BorisIvanovGIT/DiplomnaRabota/Layout Snips/3D_BOT_2.png

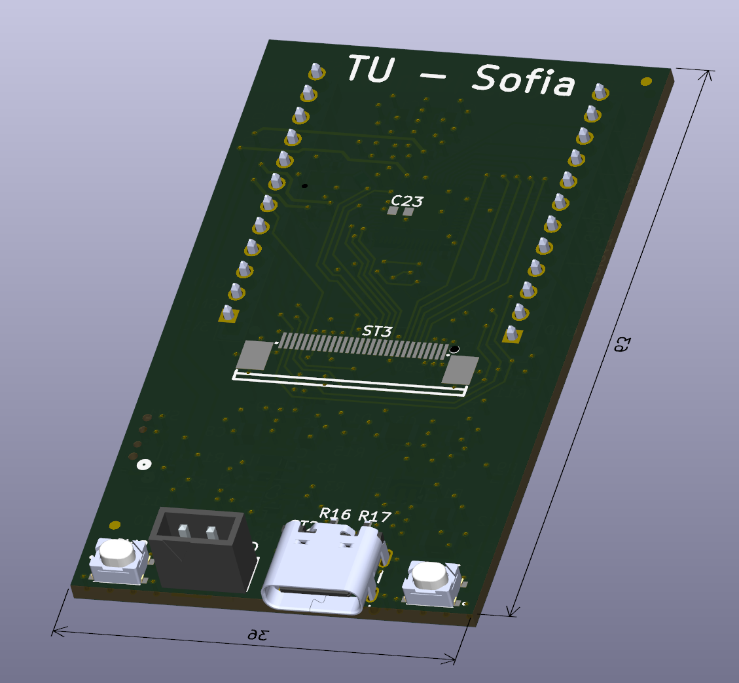
Layout Snips/3D_BOT_2.png
