BorisIvanovGIT/DiplomnaRabota/Layout Snips/3D_TOP_2.png

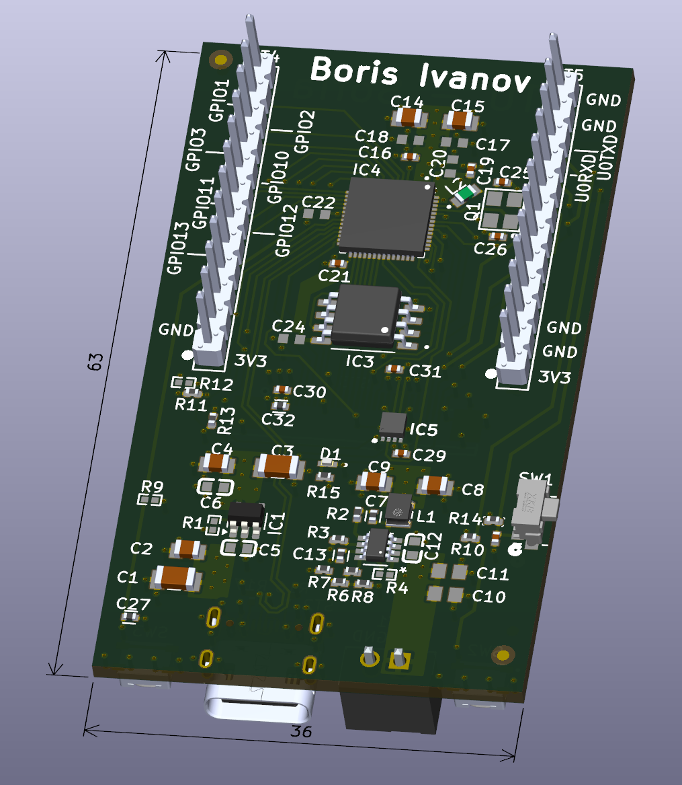
Layout Snips/3D_TOP_2.png
