BorisIvanovGIT/DiplomnaRabota/Layout Snips/3D_BOT.png

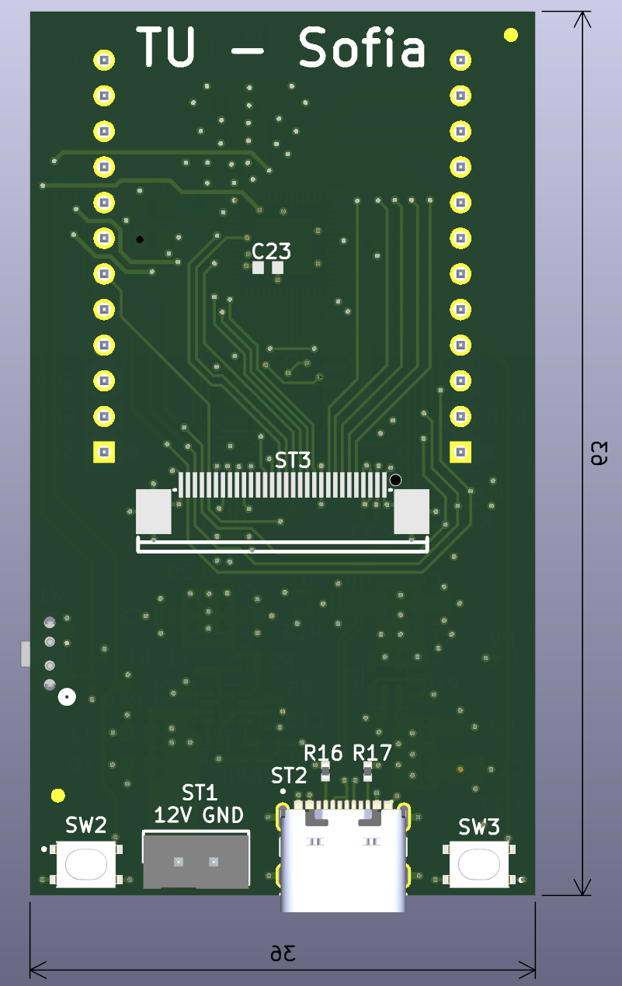
Layout Snips/3D_BOT.png
