BorisIvanovGIT/DiplomnaRabota/Layout Snips/3D_TOP.png

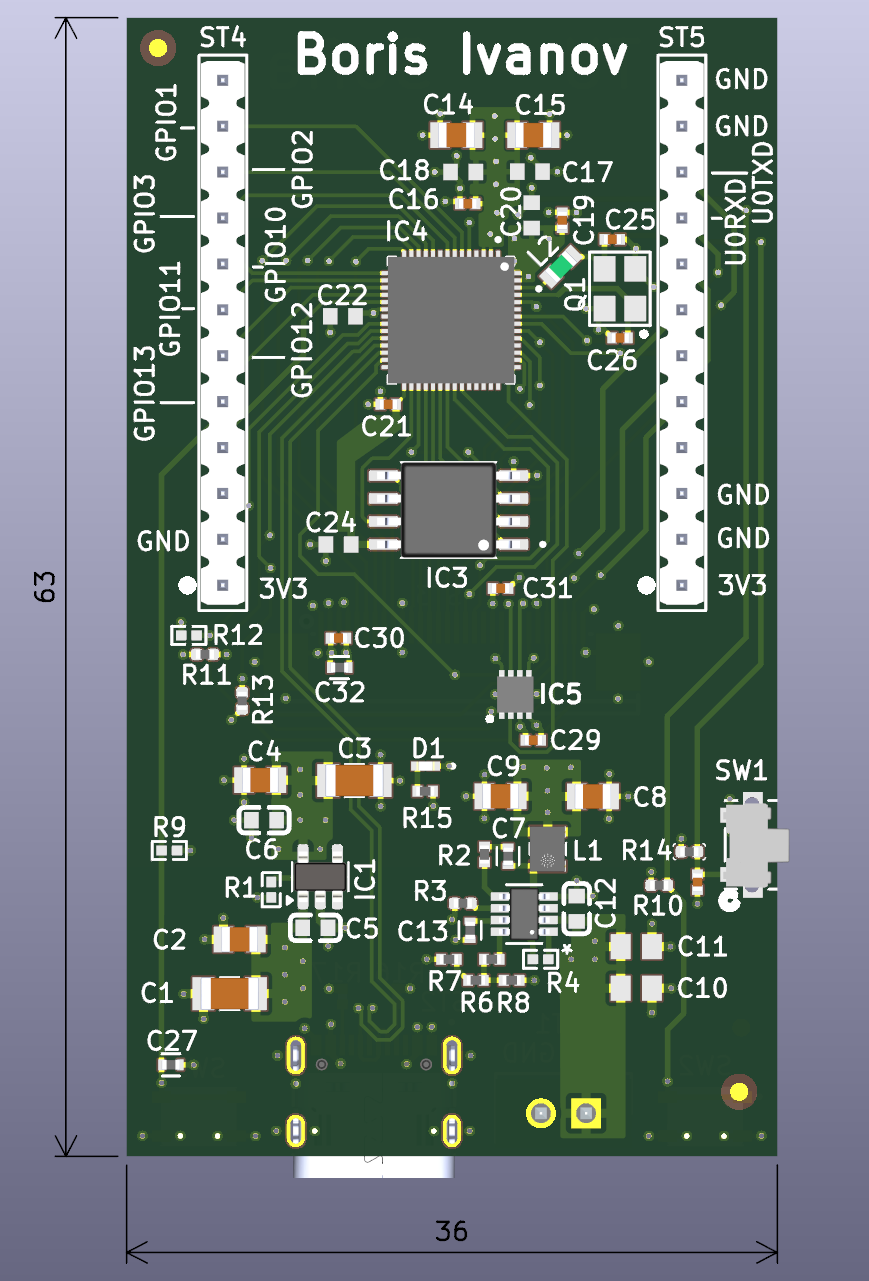
Layout Snips/3D_TOP.png
