BorisIvanovGIT/DiplomnaRabota/Layout Snips/BOT.png

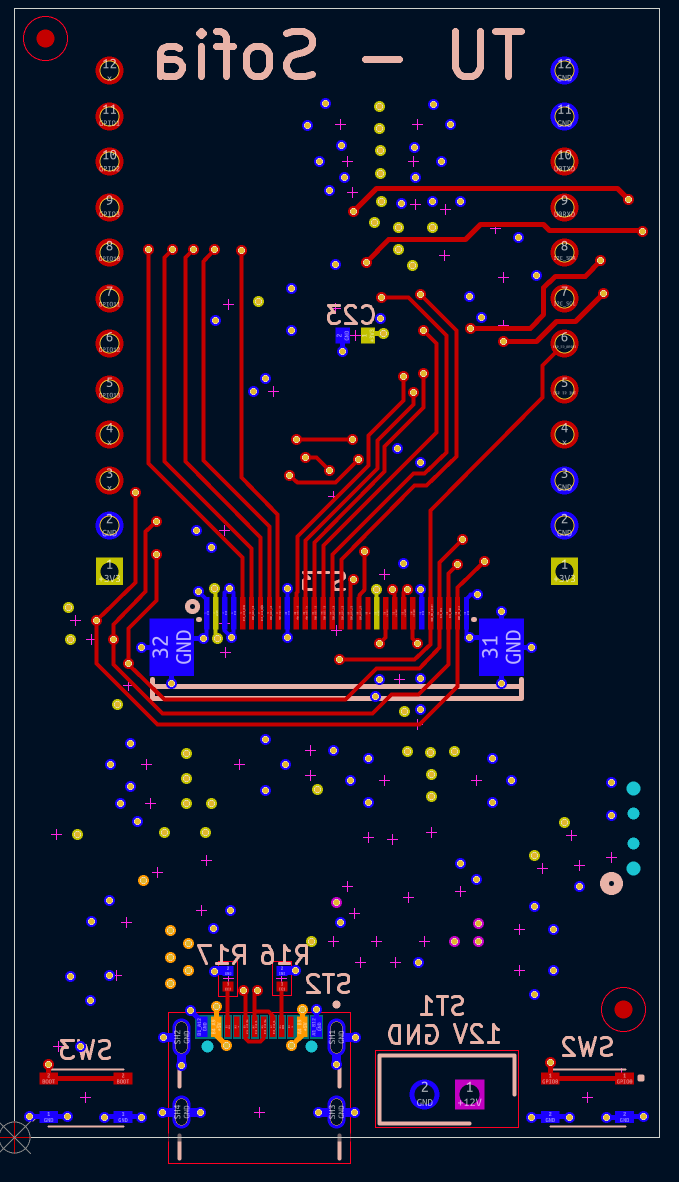
Layout Snips/BOT.png
