BorisIvanovGIT/DiplomnaRabota/Layout Snips/INNER_LAYER.png

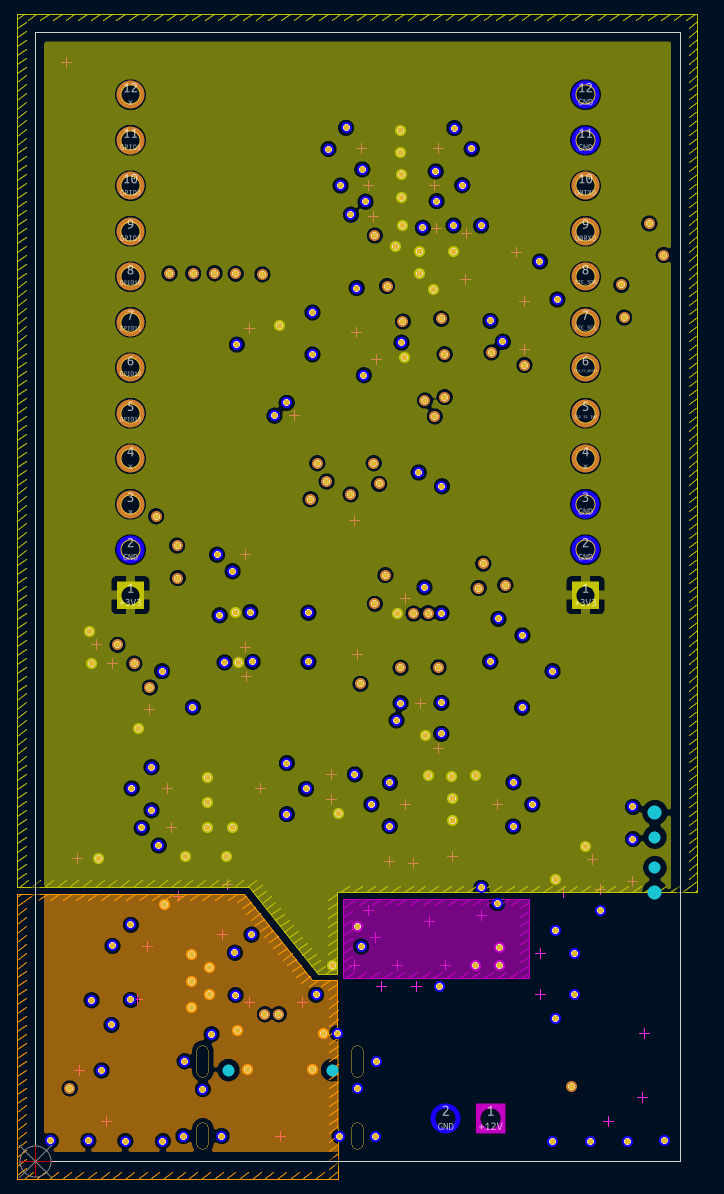
Layout Snips/INNER_LAYER.png
