BorisIvanovGIT/DiplomnaRabota/Layout Snips/TOP.png

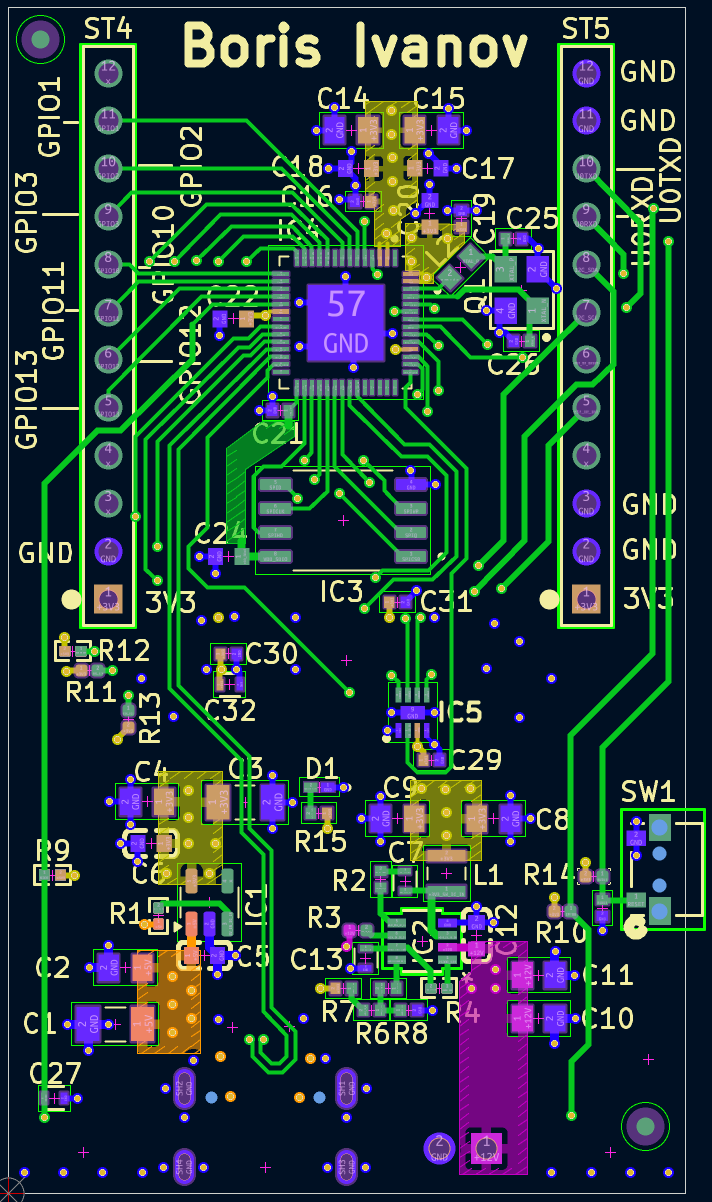
Layout Snips/TOP.png
