BorisIvanovGIT/DiplomnaRabota/BOM/ESP32_BOARD_BOM.xlsx

Comment | Designator | Footprint
GRM31CR61A476ME15L | C1,C3 | CAPC3216X180N
GRM21BR61A226ME51L | C2,C4,C8,C9,C14,C15 | CAPC2012X140N
CC0603KRX7R9BB104 | C5,C6,C12,C17,C18,C20,C22,C23,C24 | CC0603KRX7R9BB104
CC0402KRX7R7BB104 | C7,C13,C27,C32 | CAPC1005X55N
CL21A106KAYNNNE | C10,C11 | CAPC2012X135N
GRM155R60J105KE19D | C16,C19,C21,C28,C29,C30,C31 | CAPC1005X55N
GRM1555C1H150JA01D | C25,C26 | CAPC1005X55N
APHHS1005CGCK | D1 | LED_APHHS1005CGCK
AP2112K-3.3 | IC1 | SOT-23-5
MPQ4420HGJ-Z | IC2 | TSOT23-8_MPQ4420H_MNP
W25Q128JVSIQ | IC3 | SOIC127P790X216-8N
ESP32-S3R8 | IC4 | QFN40P700X700X90-57N
AW9364DNR | IC5 | SON50P200X200X80-9N-D
VLS252012HBX-100M-1; 10uH | L1 | IND_VLS252012HBX-100M-1
LQG18HN22NJ00D; 22nH | L2 | INDC1608X95N
S3240000151040 | Q1 | CRYSTAL-SMD_4P-L3.2-W2.5-BL
RC0402FR-07100KL | R1,R4,R9,R12 | RC0402FR-07100KL
RC0402JR-0720RL | R2 | RESC1005X40N
RC0402JR-071ML | R3 | R0402
RC0402FR-0751KL | R5 | RESC1005X40N
RC0402FR-0733KL | R6 | RESC1005X40N
RC0402FR-078K2L | R7 | RESC1005X40N
0402WGF1302TCE | R8 | RESC1005X40N
RC0402JR-0710KL | R10,R11,R13,R14 | RC0402JR-0710KL
RC0402FR-07220RL | R15 | RESC1005X40N
0402WGF5101TCE | R16,R17 | RESC1005X40N
B2B-EH-A (LF)(SN) | ST1 | SHDR2W64P0X250_1X2_750X380X600P
USB4105-GF-A | ST2 | GCT_USB4105-GF-A
KH-CL0.5-H2.0-30PIN | ST3 | KH-CL0.5-H2.0-30PIN
12P_2.54_X6511WV-12H-C60D30 | ST4,ST5 | X6511WV-12H-C60D30
TS-1010B-B-A | SW1 | SW_010B-B-A_XKB
PTS810SJK250SMTRLFS | SW2,SW3 | PTS810SJG250SMTRLFS
