BorisIvanovGIT/DiplomnaRabota/components/APHHS1005CGCK/APHHS1005CGCK.step

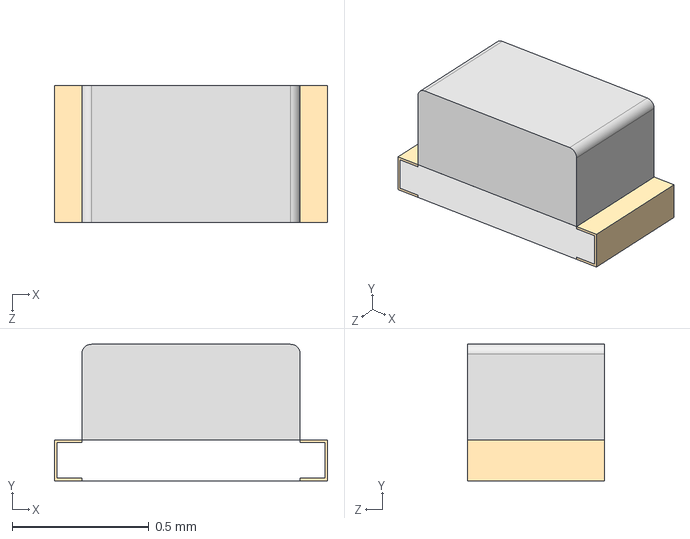
[picture p8: CAD file, 2025-04-14]
components/APHHS1005CGCK/APHHS1005CGCK.step
1.00 x 0.5 x 0.5 mm
