BorisIvanovGIT/DiplomnaRabota/components/AW9364DNR/AW9364DNR.stp

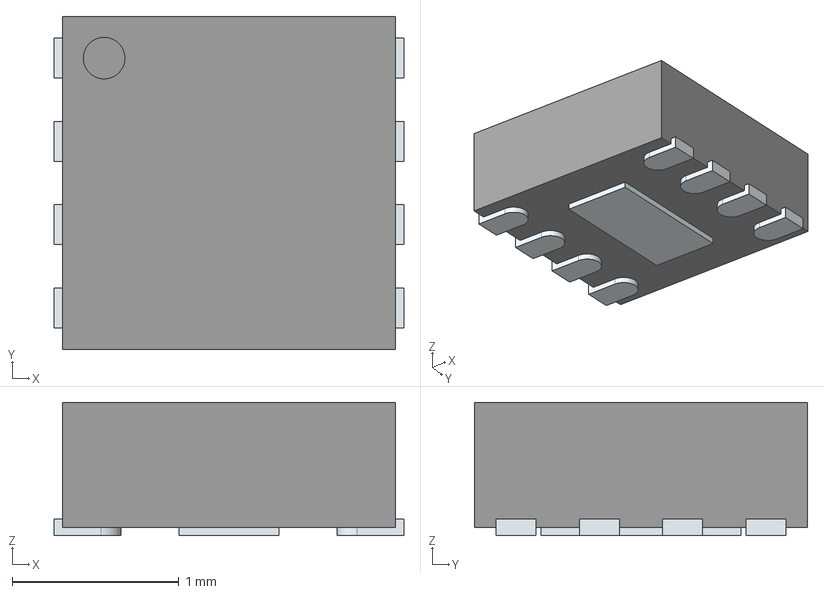
[picture p9: CAD file, 2025-04-16]
components/AW9364DNR/AW9364DNR.stp
2.10 x 2.00 x 0.8 mm
ThermalPin
PinsArrayLR
