BorisIvanovGIT/DiplomnaRabota/components/Capacitors/CC0402KRX7R7BB104/CC0402KRX7R7BB104.step

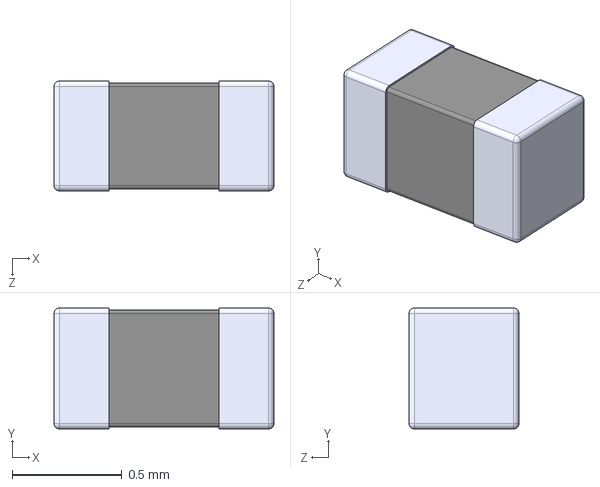
[picture p10: CAD file, 2025-04-12]
components/Capacitors/CC0402KRX7R7BB104/CC0402KRX7R7BB104.step
1.00 x 0.55 x 0.5 mm
