BorisIvanovGIT/DiplomnaRabota/components/Capacitors/CC0603KRX7R9BB104/CC0603KRX7R9BB104.step

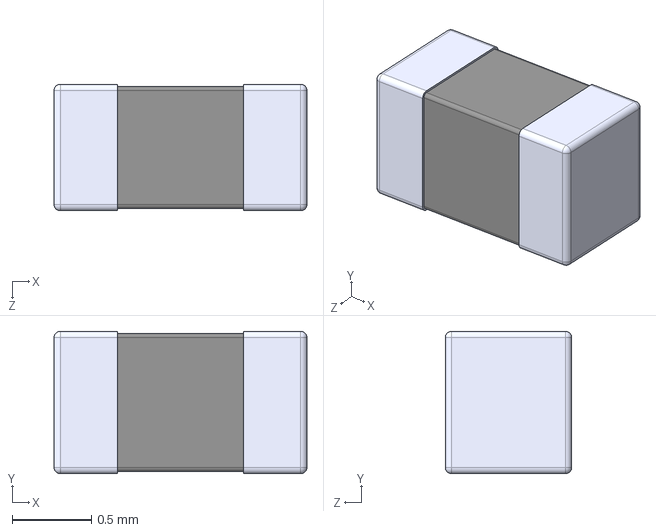
[picture p11: CAD file, 2025-04-12]
components/Capacitors/CC0603KRX7R9BB104/CC0603KRX7R9BB104.step
1.60 x 0.9 x 0.8 mm
