BorisIvanovGIT/DiplomnaRabota/components/Capacitors/GRM21BR61A226ME51L/GRM21BR61A226ME51L.step

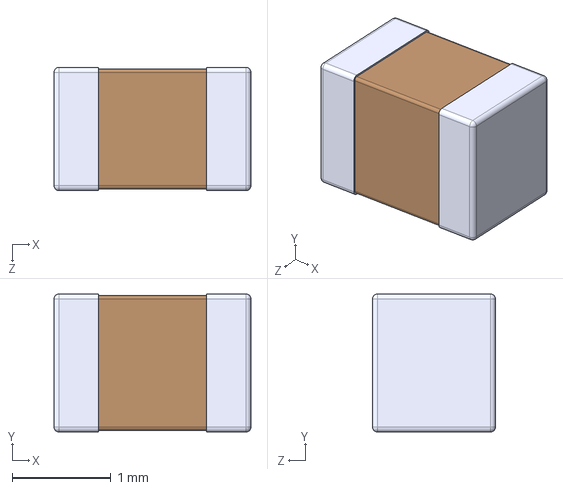
[picture p12: CAD file, 2025-04-12]
components/Capacitors/GRM21BR61A226ME51L/GRM21BR61A226ME51L.step
2.00 x 1.40 x 1.25 mm
