BorisIvanovGIT/DiplomnaRabota/components/Capacitors/GRM31CR61A476ME15L/GRM31CR61A476ME15L.step

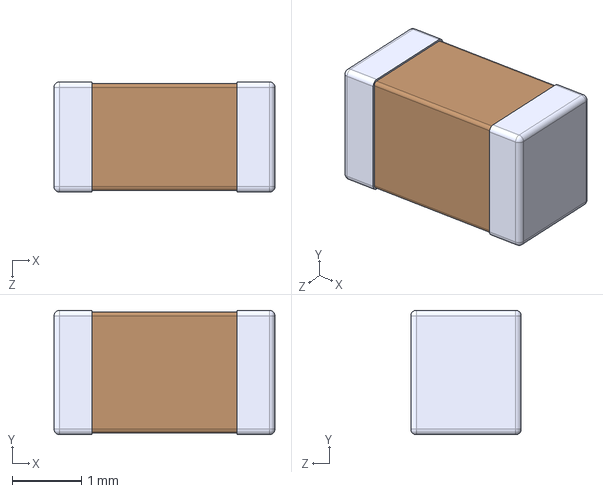
[picture p13: CAD file, 2025-04-12]
components/Capacitors/GRM31CR61A476ME15L/GRM31CR61A476ME15L.step
3.20 x 1.80 x 1.60 mm
