BorisIvanovGIT/DiplomnaRabota/components/ESP32-S3R8/ESP32-S3R8.step

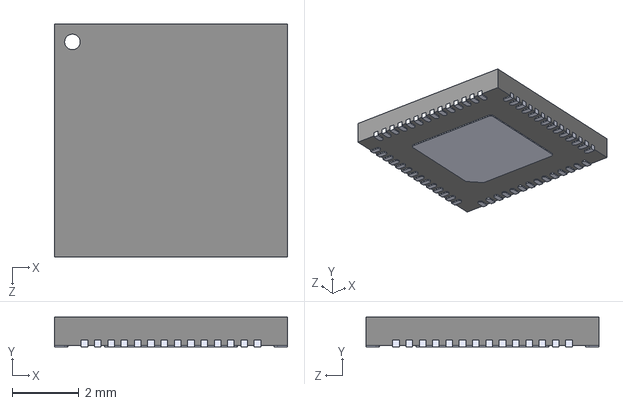
[picture p14: CAD file, 2025-04-12]
components/ESP32-S3R8/ESP32-S3R8.step
7.00 x 0.9 x 7.00 mm
