BorisIvanovGIT/DiplomnaRabota/components/JST_B2B-EH-A-LF-SN/B2B-EH-A_LF__SN_.stp

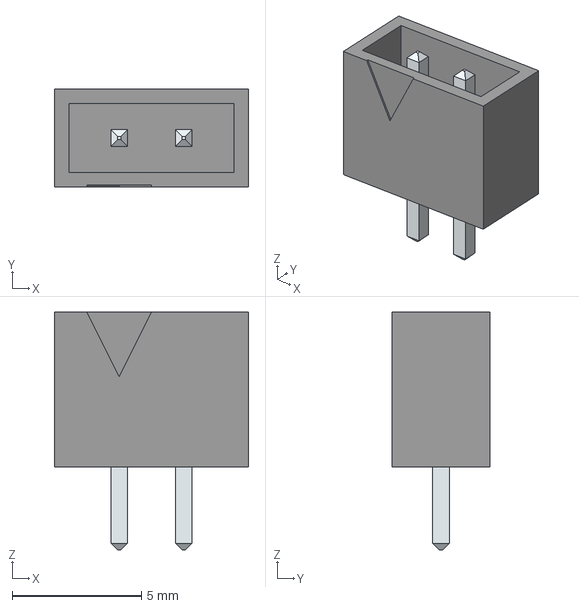
[picture p15: CAD file, 2025-04-16]
components/JST_B2B-EH-A-LF-SN/B2B-EH-A_LF__SN_.stp
7.50 x 3.80 x 9.20 mm
LeadsArray
