BorisIvanovGIT/DiplomnaRabota/components/LQG18HN22NJ00D/LQG18HN22NJ00D.step

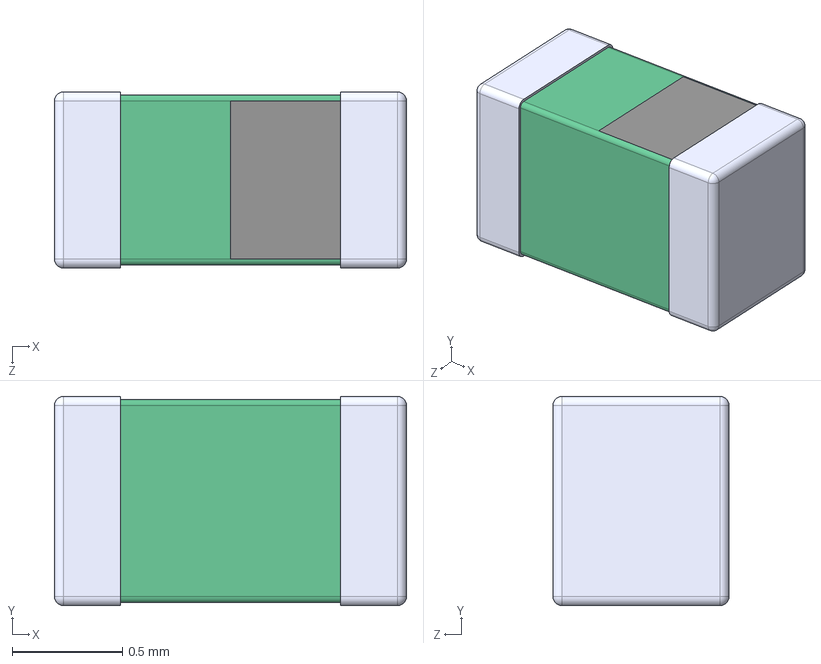
[picture p16: CAD file, 2025-04-12]
components/LQG18HN22NJ00D/LQG18HN22NJ00D.step
1.60 x 0.95 x 0.8 mm
