BorisIvanovGIT/DiplomnaRabota/components/MPQ4420HGJ-Z/MPQ4420HGJ-Z.step

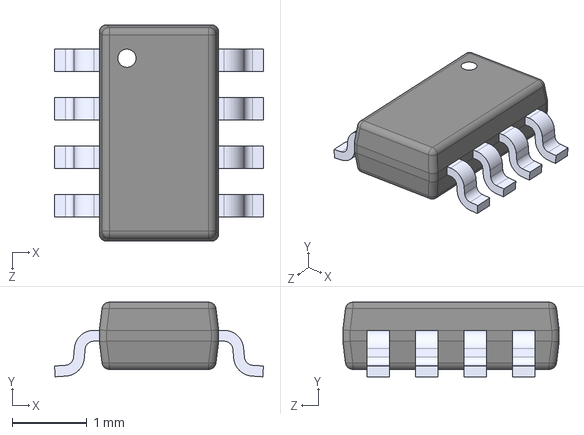
[picture p17: CAD file, 2025-04-12]
components/MPQ4420HGJ-Z/MPQ4420HGJ-Z.step
2.80 x 1 x 2.90 mm
