BorisIvanovGIT/DiplomnaRabota/components/Project Buttons/PTS810SJK250SMTRLFS/PTS810SJK250SMTRLFS.step

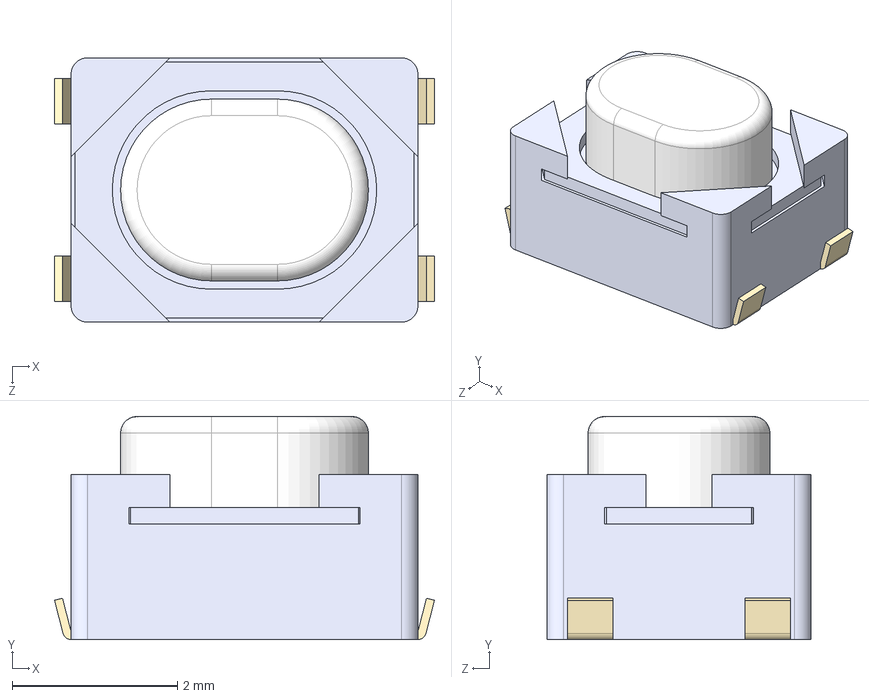
[picture p18: CAD file, 2025-04-12]
components/Project Buttons/PTS810SJK250SMTRLFS/PTS810SJK250SMTRLFS.step
4.60 x 2.70 x 3.20 mm
