BorisIvanovGIT/DiplomnaRabota/components/Project Buttons/TS-1010B-B-A/ts-1010b-b-a.stp

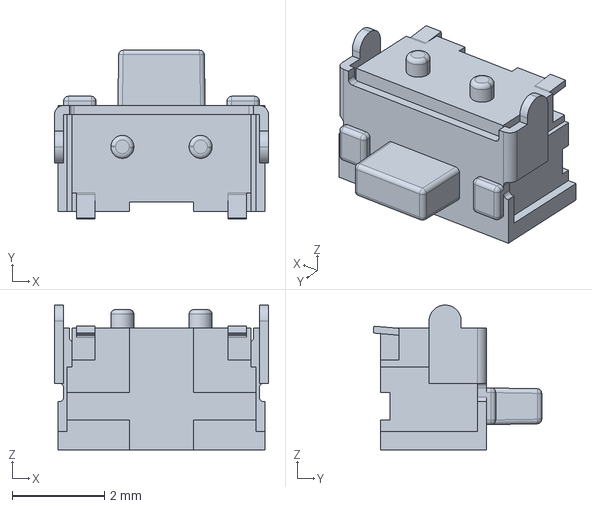
[picture p19: CAD file, 2025-04-16]
components/Project Buttons/TS-1010B-B-A/ts-1010b-b-a.stp
4.65 x 3.66 x 3.15 mm
