BorisIvanovGIT/DiplomnaRabota/components/Resistors/0402WGF5101TCE/0402WGF5101TCE.step

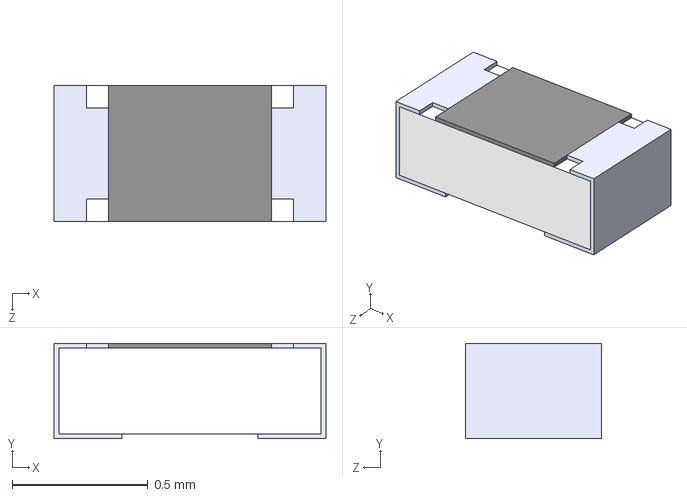
[picture p20: CAD file, 2025-04-12]
components/Resistors/0402WGF5101TCE/0402WGF5101TCE.step
1 x 0.35 x 0.5 mm
