BorisIvanovGIT/DiplomnaRabota/components/Resistors/RC0402FR-07100KL/RC0402FR-07100KL.step

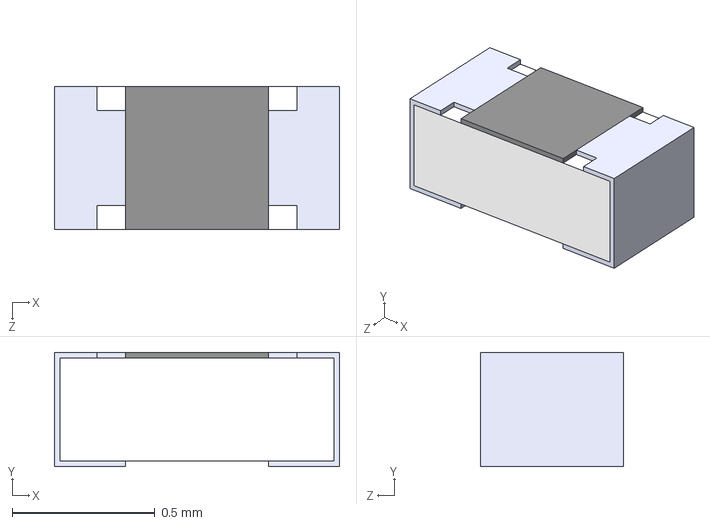
[picture p21: CAD file, 2025-04-12]
components/Resistors/RC0402FR-07100KL/RC0402FR-07100KL.step
1 x 0.4 x 0.5 mm
