BorisIvanovGIT/DiplomnaRabota/components/TYPE-C_16PIN_2MD__073_/TYPE-C_16PIN_2MD__073_.step

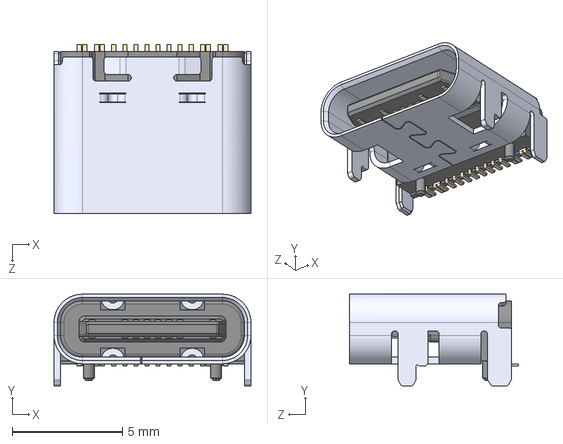
[picture p22: CAD file, 2025-04-24]
components/TYPE-C_16PIN_2MD__073_/TYPE-C_16PIN_2MD__073_.step
8.94 x 4.16 x 7.65 mm
