BorisIvanovGIT/DiplomnaRabota/components/USB4105-GF-A/USB4105-GF-A.step

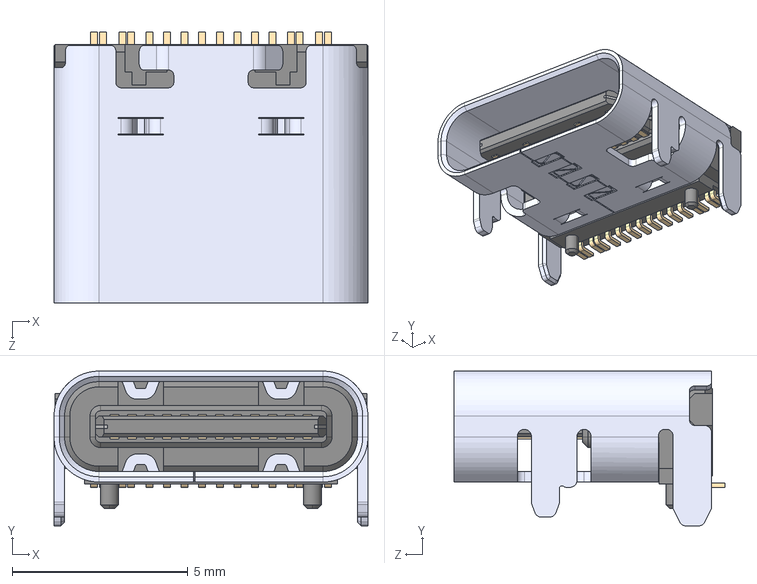
[picture p23: CAD file, 2025-04-12]
components/USB4105-GF-A/USB4105-GF-A.step
8.94 x 4.41 x 7.71 mm
