BorisIvanovGIT/DiplomnaRabota/components/W25Q128JVSIQ/W25Q128JVSIQ.step

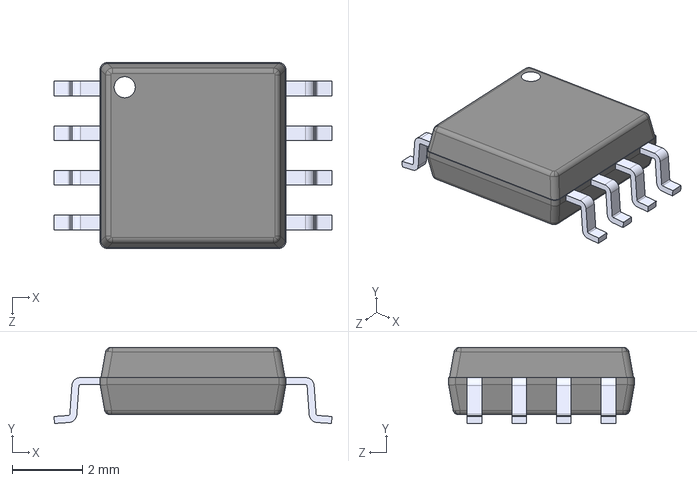
[picture p24: CAD file, 2025-04-12]
components/W25Q128JVSIQ/W25Q128JVSIQ.step
7.90 x 2.16 x 5.28 mm
