BorisIvanovGIT/DiplomnaRabota/(list of files, cad)

Other CAD files:
components/Capacitors/GRM1555C1H120JA01D/GRM1555C1H120JA01D.step
components/Capacitors/GRM1555C1H150JA01D/GRM1555C1H150JA01D.step
components/Capacitors/GRM155R60J105KE19D/GRM155R60J105KE19D.step
components/Resistors/RC0402FR-07220RL/RC0402FR-07220RL.step
components/Oscillator/S3240000121040.stp
components/VLS252012HBX-100M-1/VLS252012HBX-100M-1.step
components/X6511WV-12H-C60D30/KiCADv6/77311-124-12LF.step
