BorisIvanovGIT/DiplomnaRabota/ESP32_BOARD.pdf

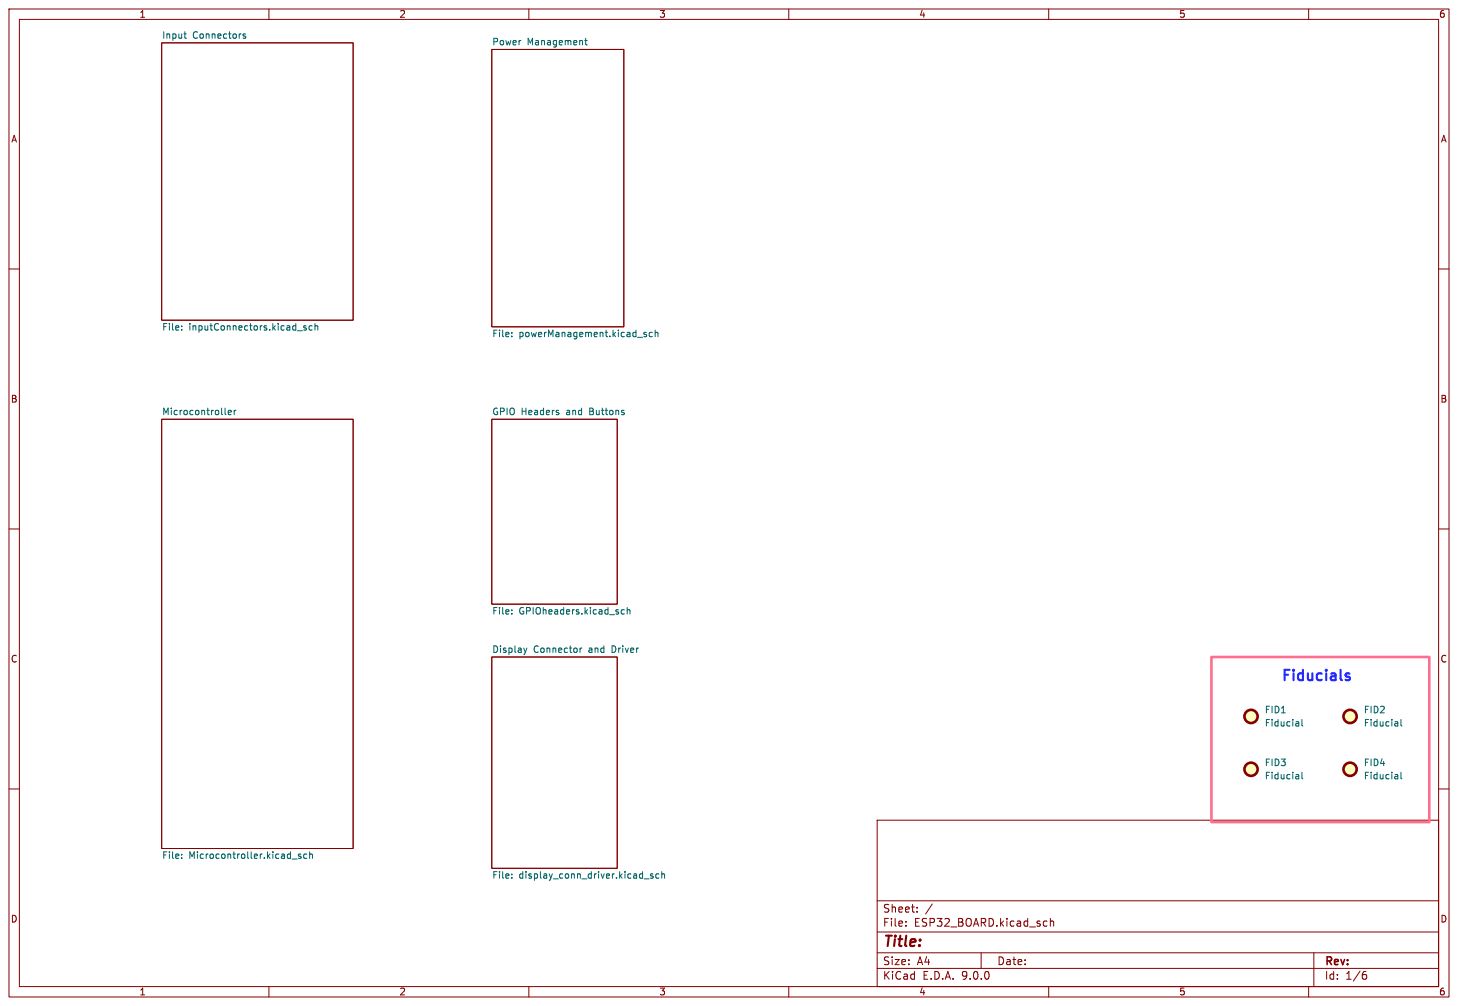
[picture p25: page 1]

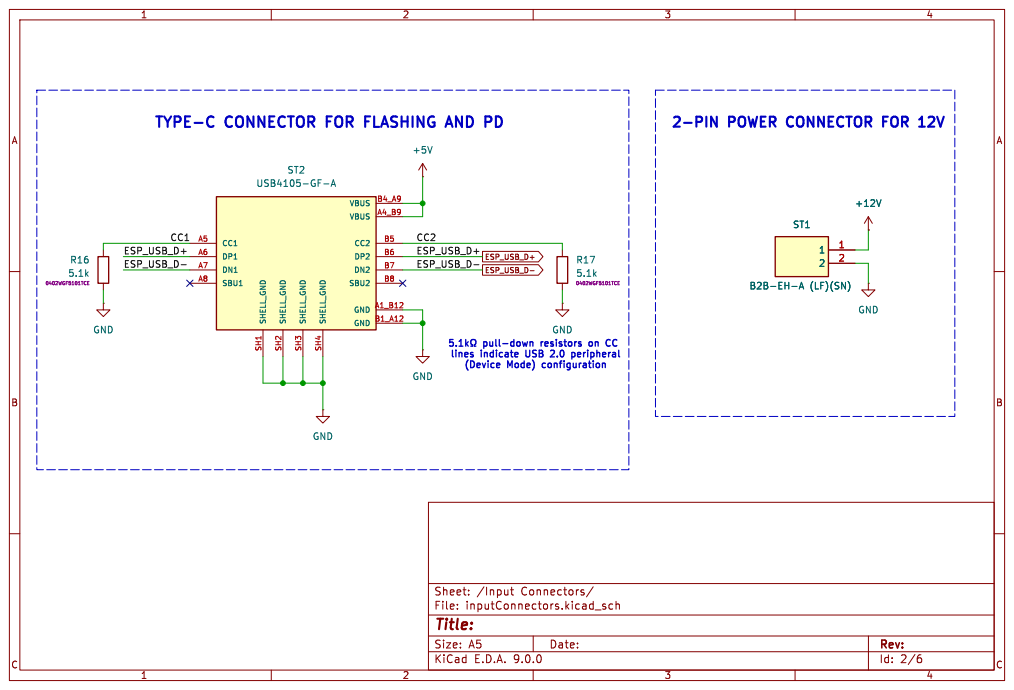
[picture p26: page 2]

lines indicate USB 2.0 peripheral
(Device Mode) configuration

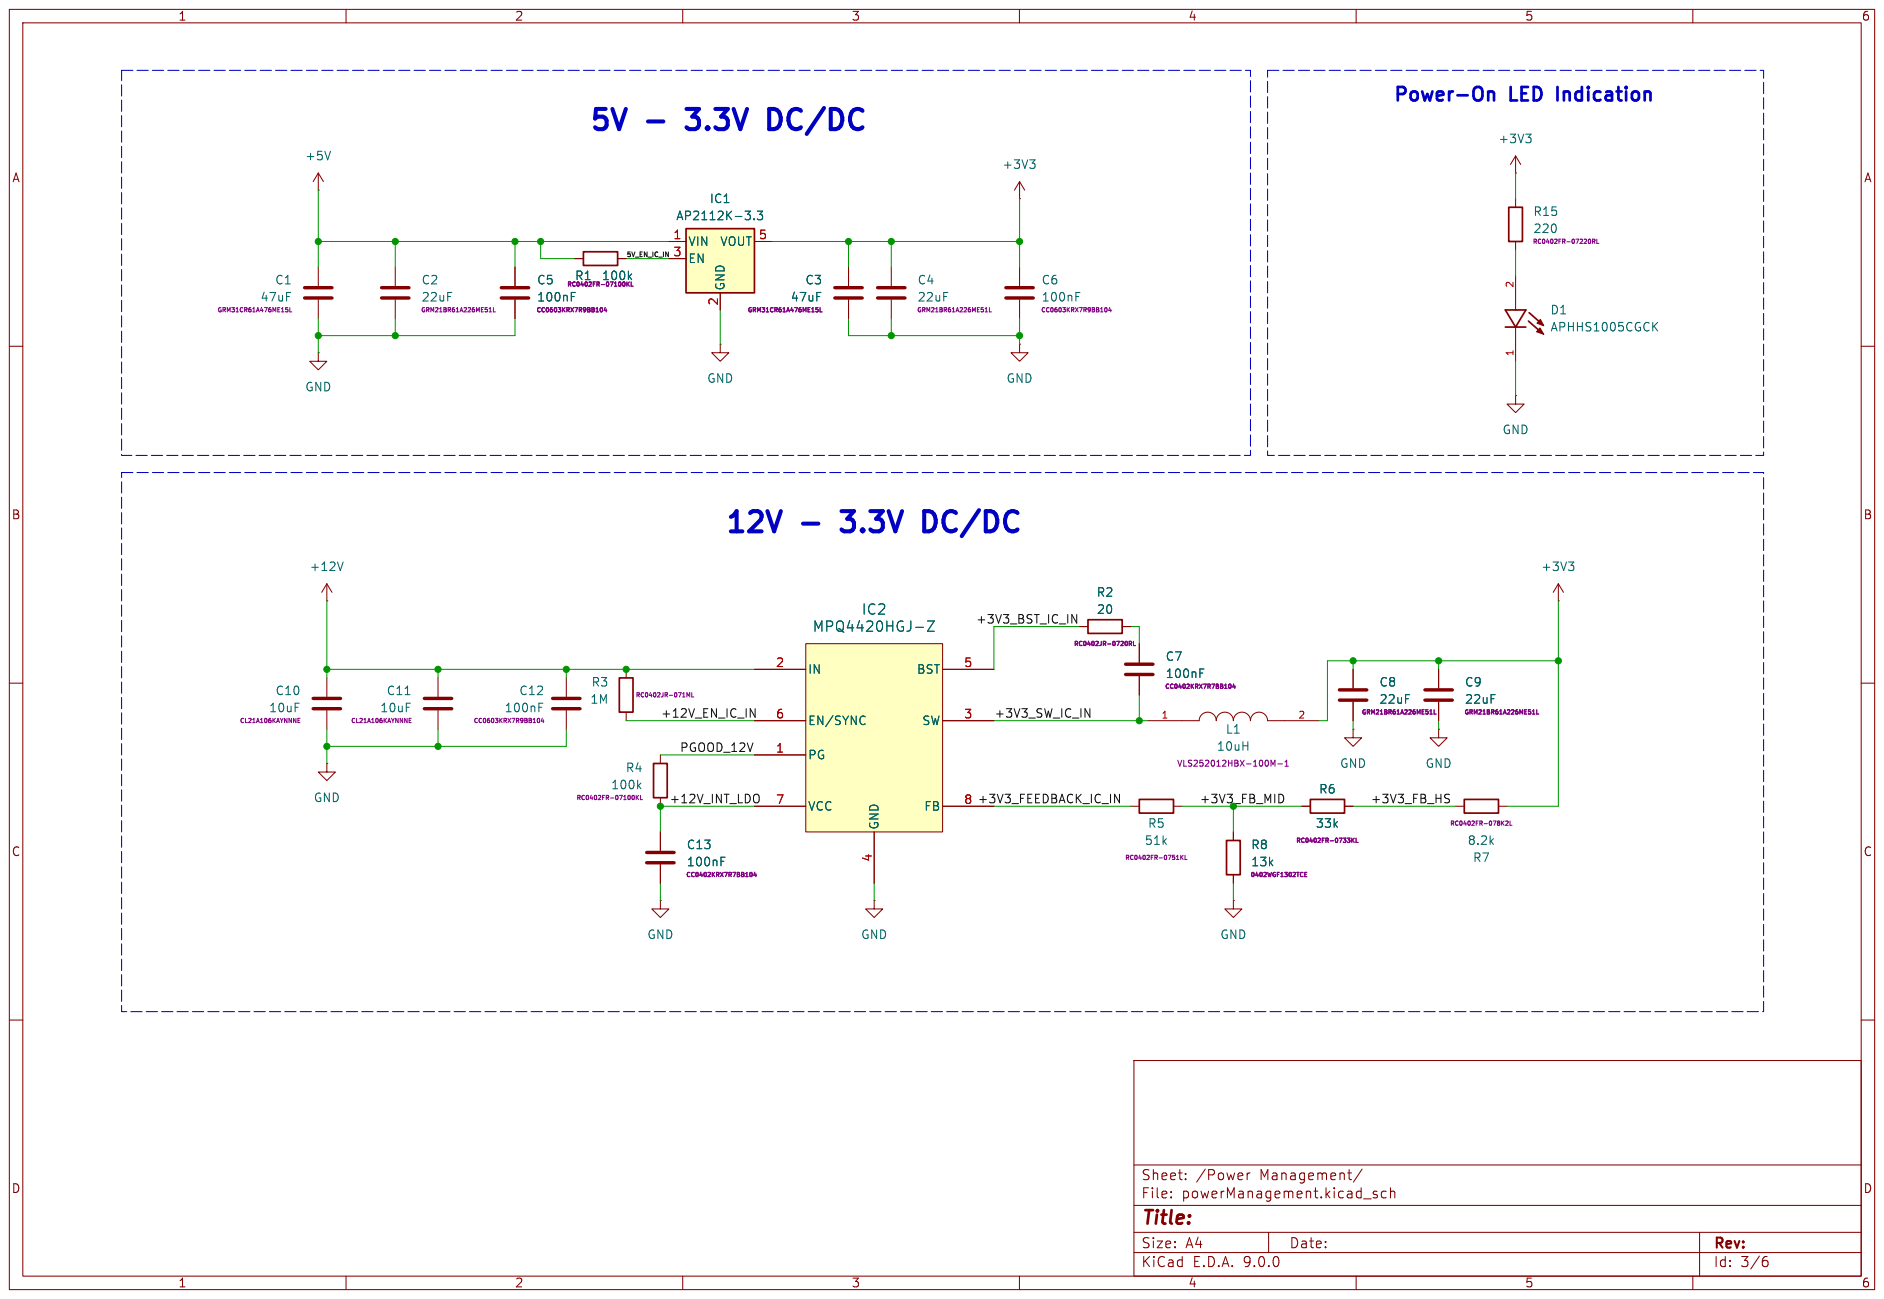
[picture p27: page 3]

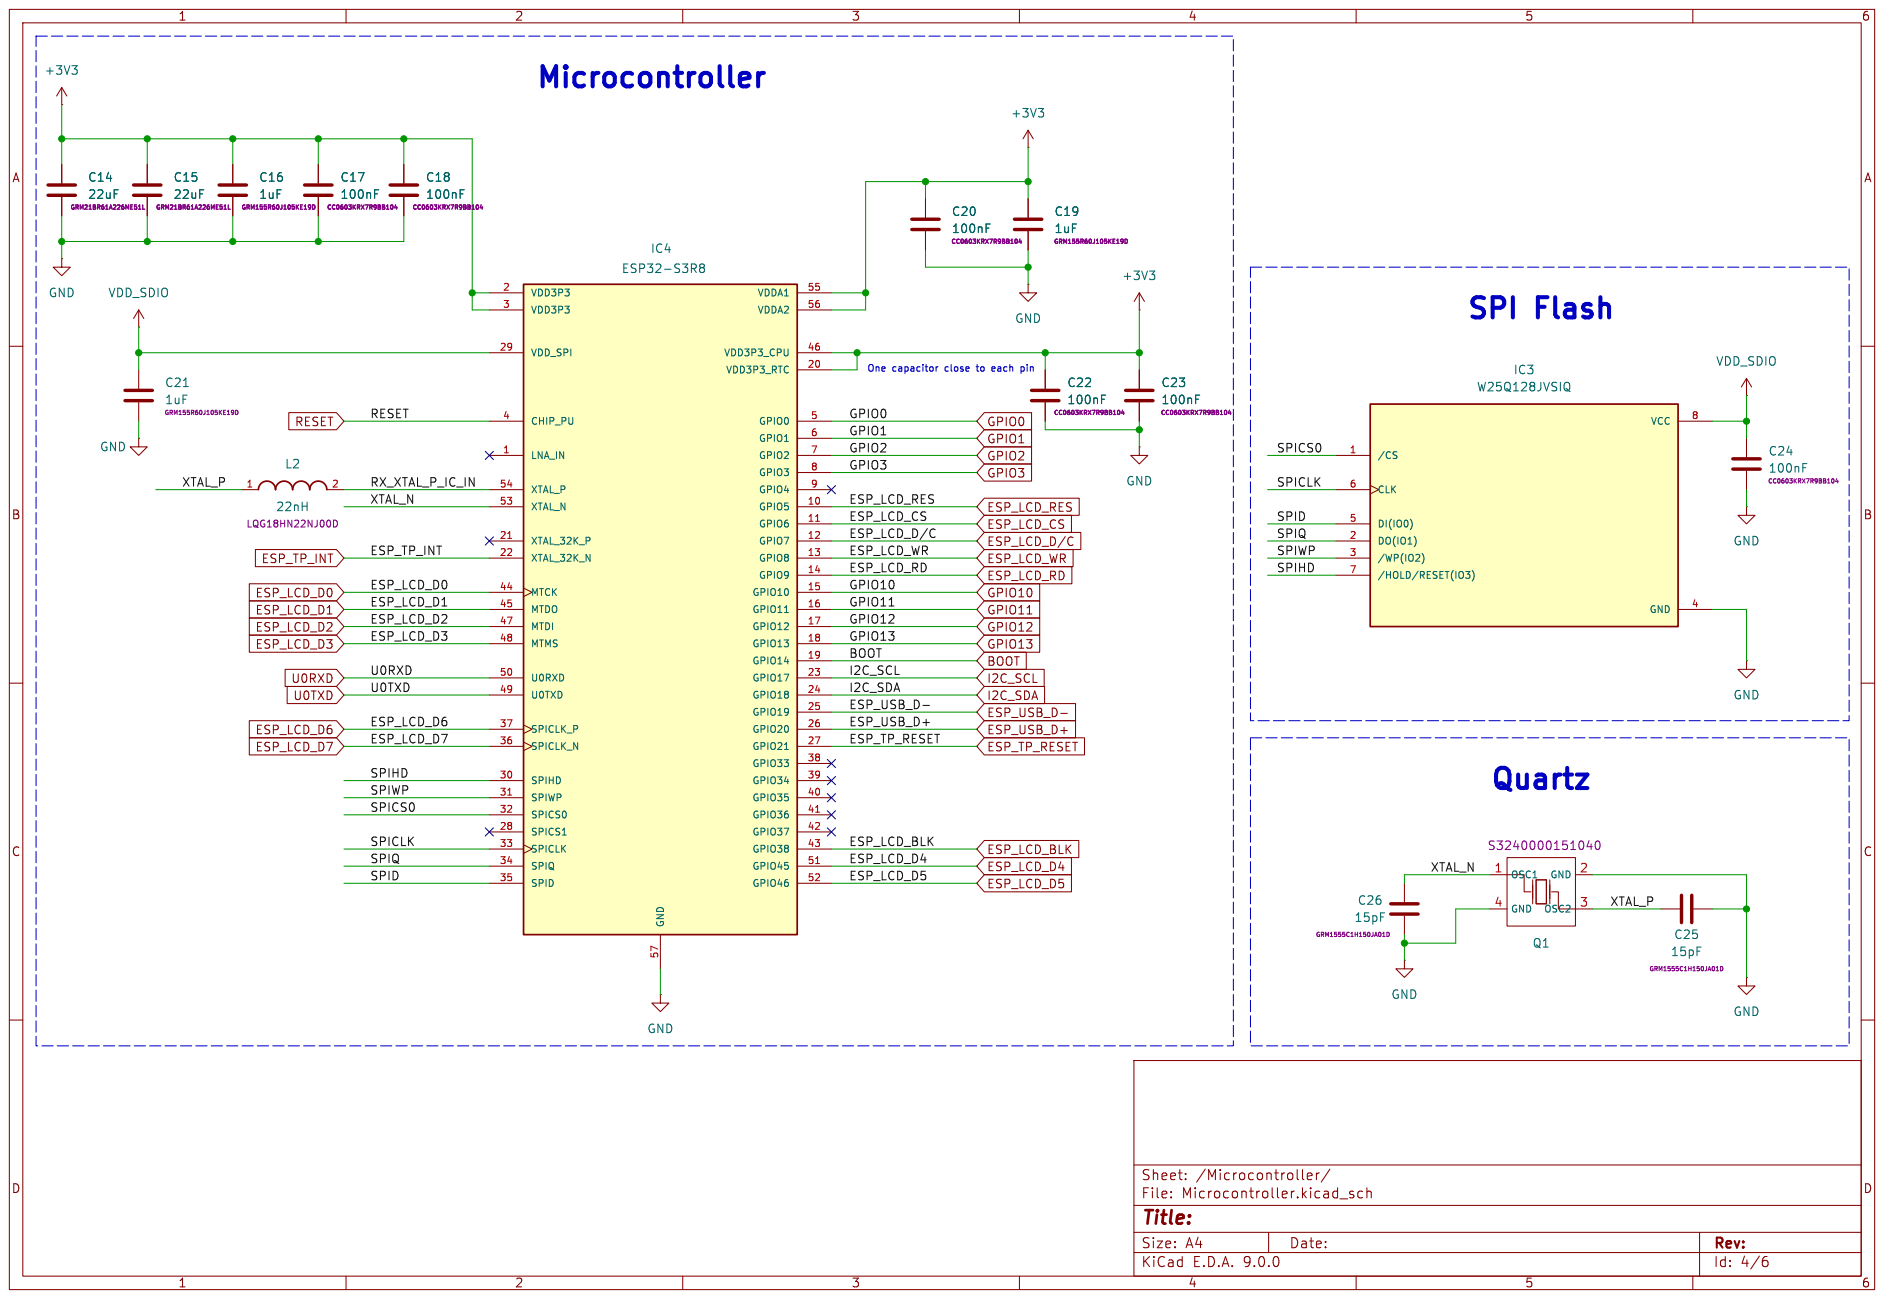
[picture p28: page 4]

Id: 4/6 Title: File: Microcontroller.kicad_sch Sheet: /Microcontroller/

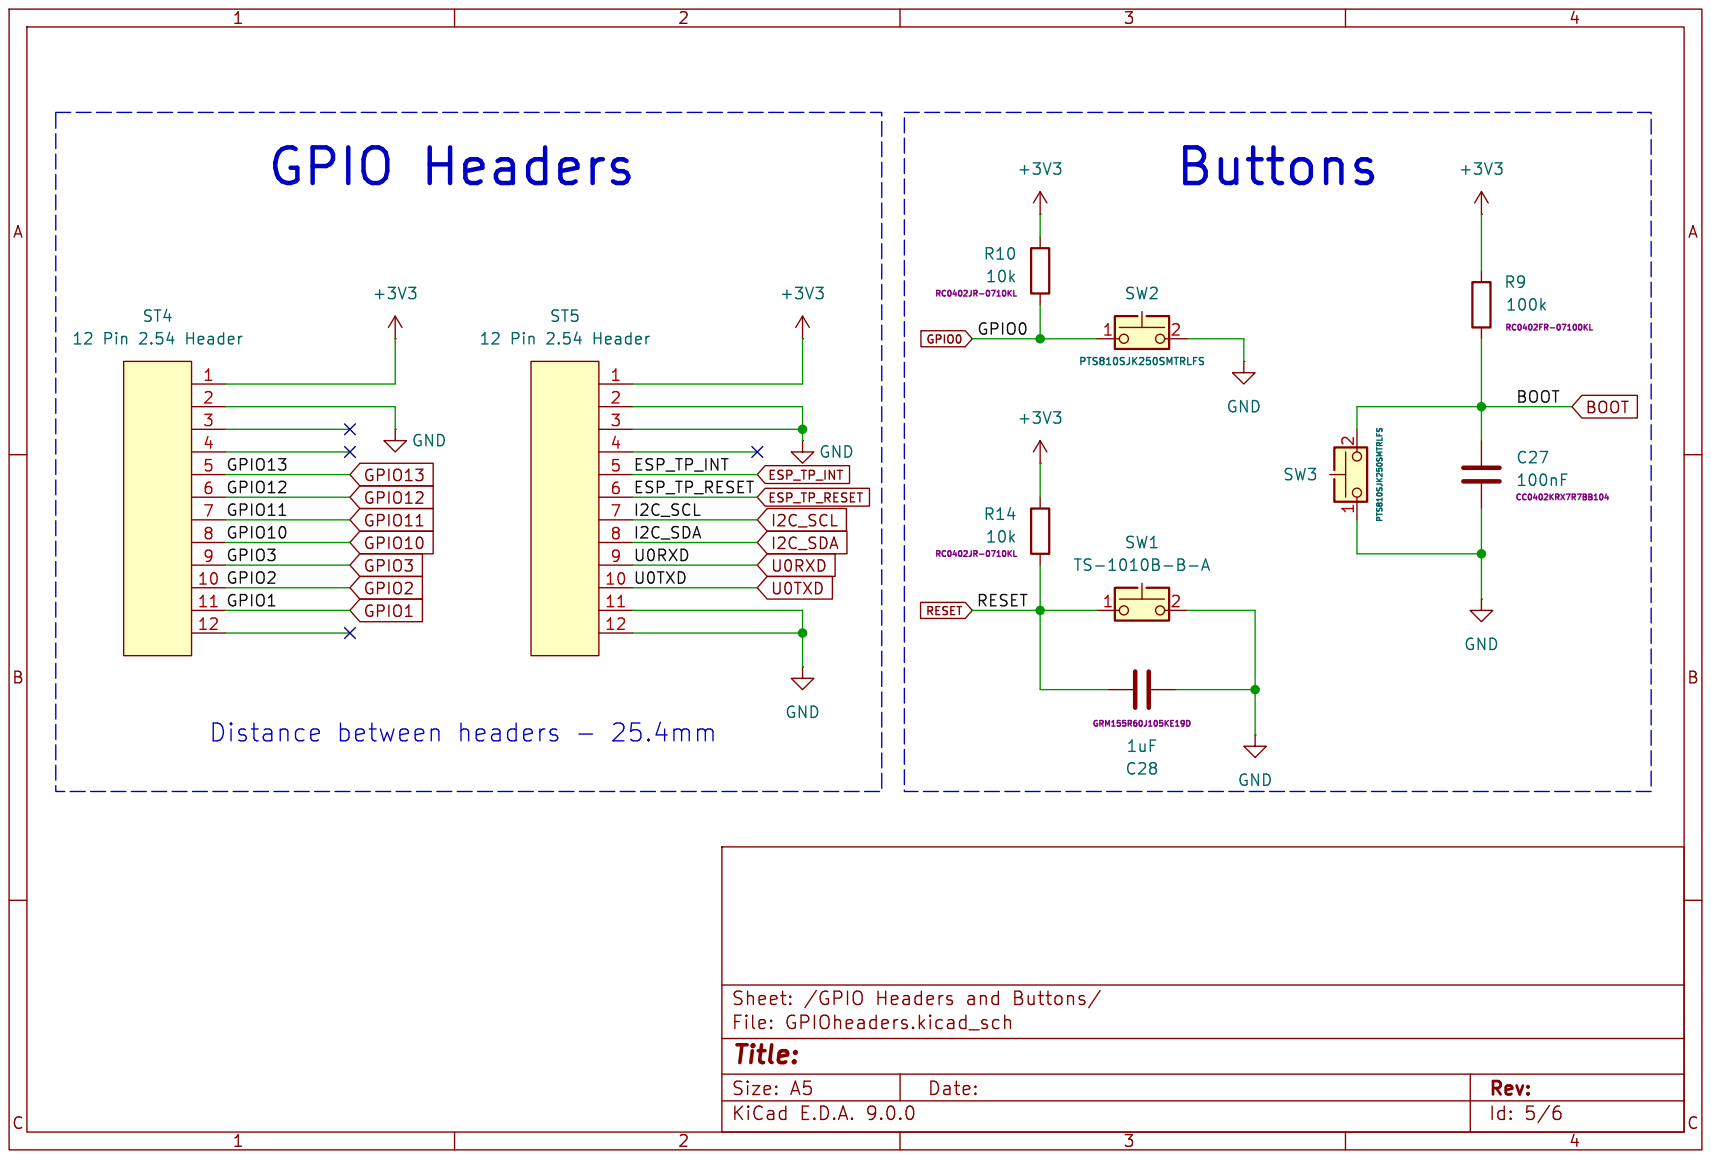
[picture p29: page 5]

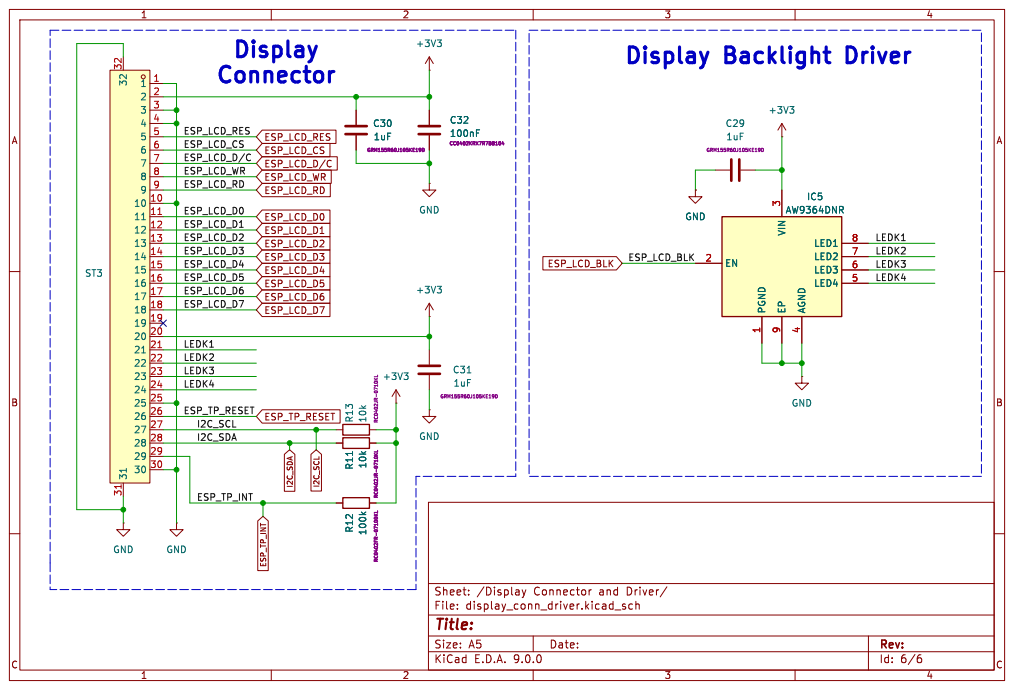
[picture p30: page 6]
