BorisIvanovGIT/DiplomnaRabota/ESP32_BOARD.kicad_pcb

## KiCad design ESP32_BOARD.kicad_pcb (2025-04-28)

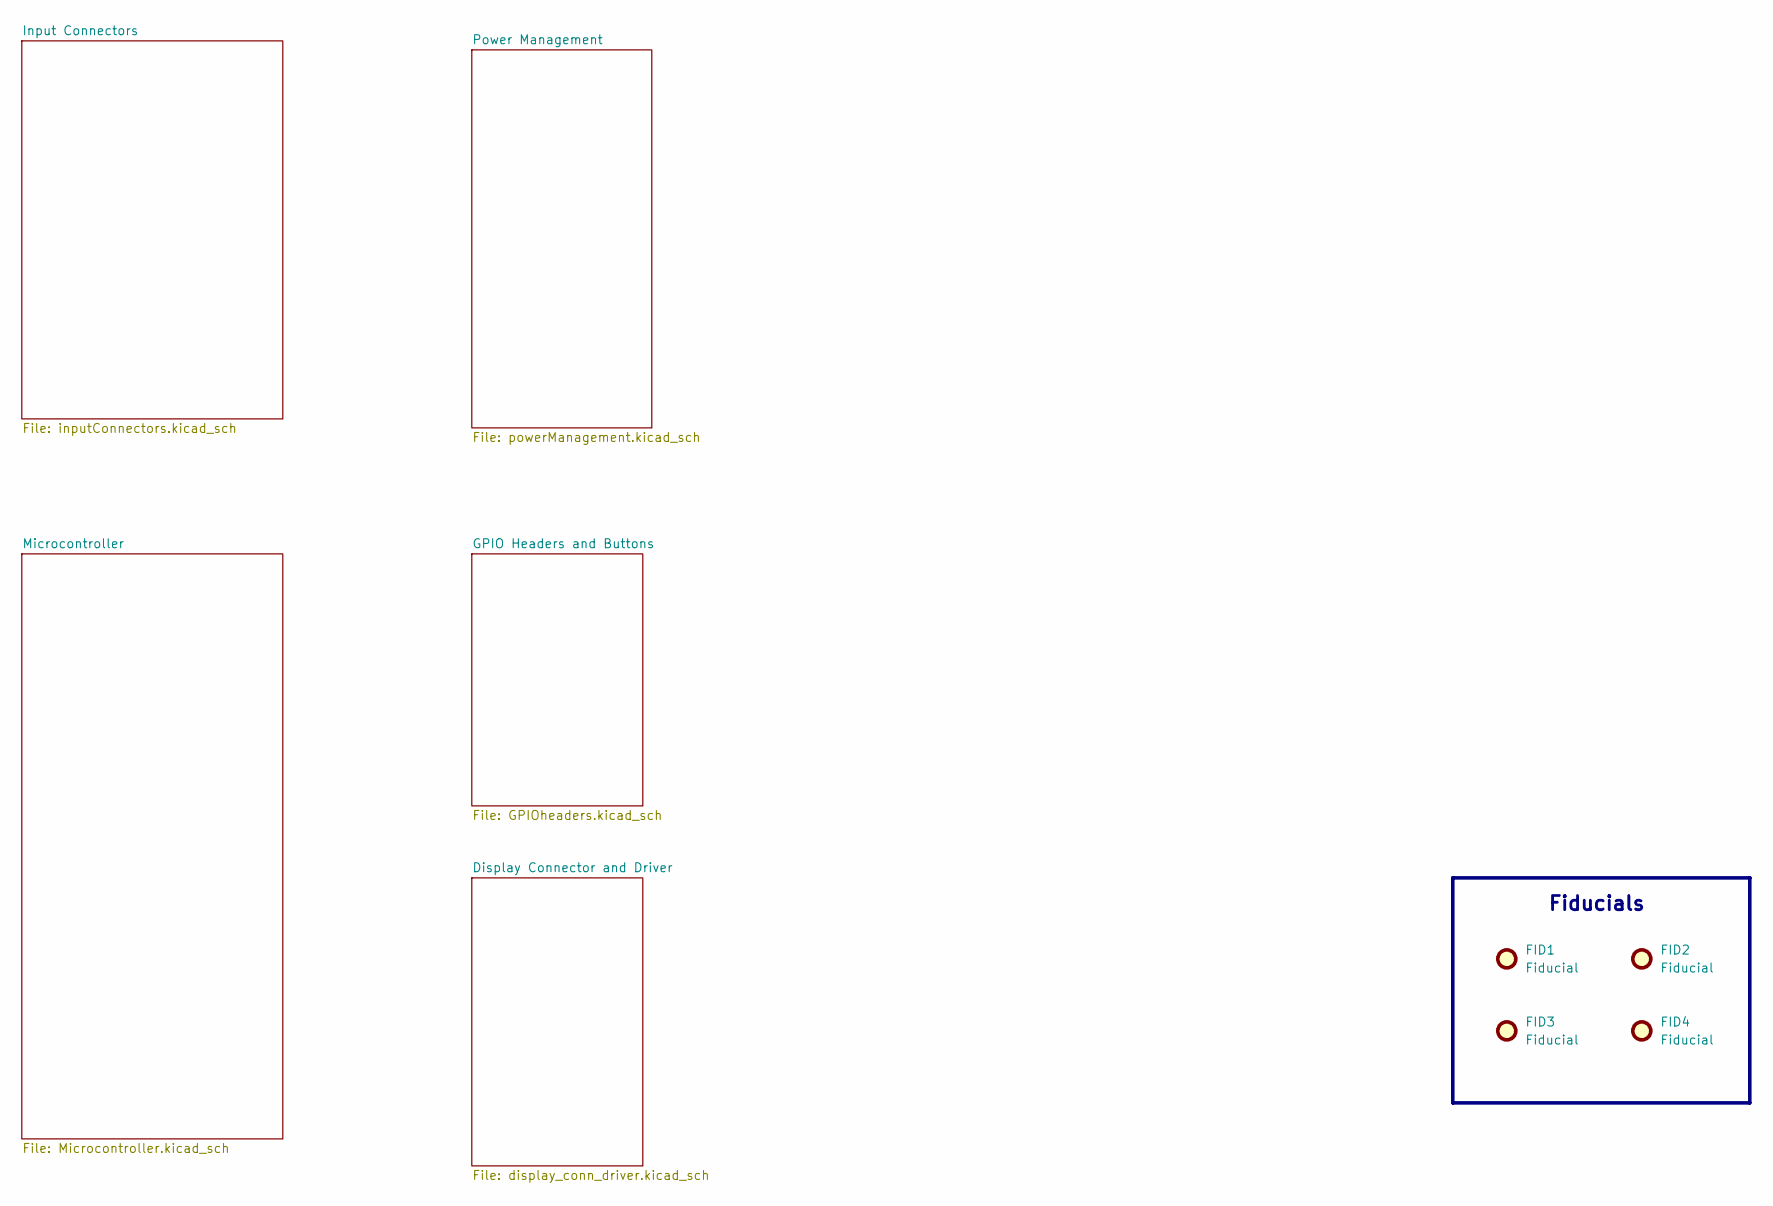
[picture p31: schematic ESP32_BOARD.kicad_sch]

Parts:
FID1, FID2, FID3, FID4: Fiducial; Fiducial_1mm_Mask2mm

Notes on the sheet:
Fiducials

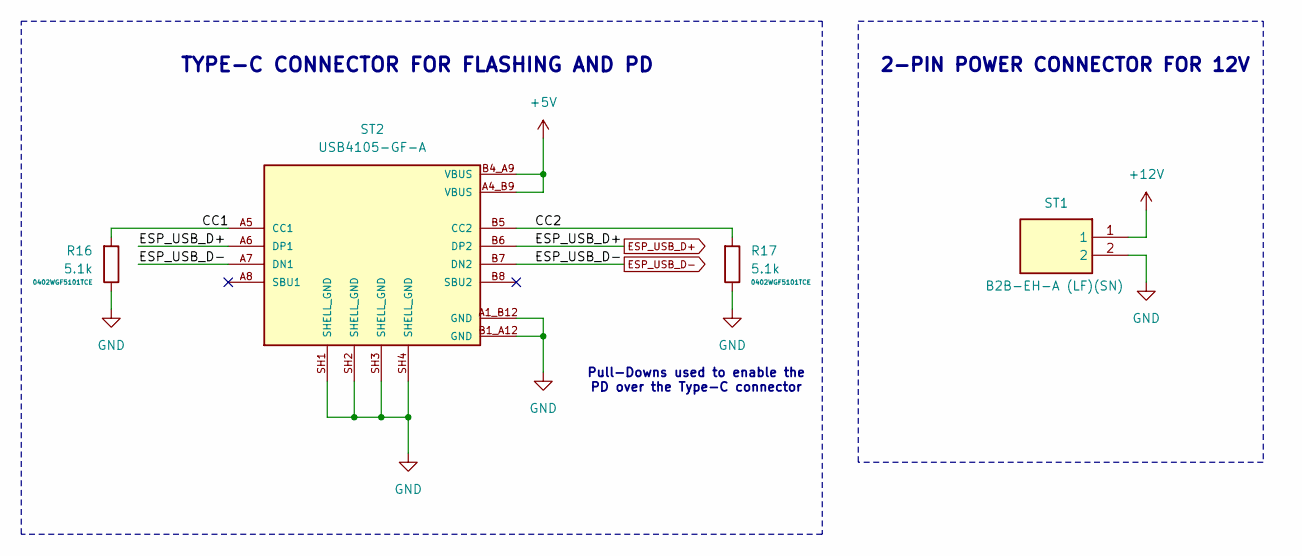
[picture p32: schematic inputConnectors.kicad_sch]

Parts:
R16, R17: 5.1k; RESC1005X40N
ST1: B2B-EH-A (LF)(SN); SHDR2W64P0X250_1X2_750X380X600P; Manufacturer_Part_Number B2B-EH-A(LF)(SN); Mouser Part Number N/A
ST2: USB4105-GF-A; GCT_USB4105-GF-A; PARTREV B4; DigiKey_Part_Number 2073-USB4105-GF-ATR-ND

Connections:
+5V: ST2.A4_B9 (VBUS), ST2.B4_A9 (VBUS); also elsewhere on the board
+12V: ST1.1; also elsewhere on the board
/Input Connectors/CC1: R16.1, ST2.A5 (CC1)
/Input Connectors/CC2: R17.1, ST2.B5 (CC2)
ESP_USB_D+: ST2.A6 (DP1), ST2.B6 (DP2); also elsewhere on the board
ESP_USB_D-: ST2.A7 (DN1), ST2.B7 (DN2); also elsewhere on the board
GND: R16.2, R17.2, ST1.2, ST2.A1_B12 (GND), ST2.B1_A12 (GND), ST2.SH1 (SHELL_GND), ST2.SH2 (SHELL_GND), ST2.SH3 (SHELL_GND), ST2.SH4 (SHELL_GND); also elsewhere on the board

Notes on the sheet:
2-PIN POWER CONNECTOR FOR 12V
Pull-Downs used to enable the PD over the Type-C connector
TYPE-C CONNECTOR FOR FLASHING AND PD

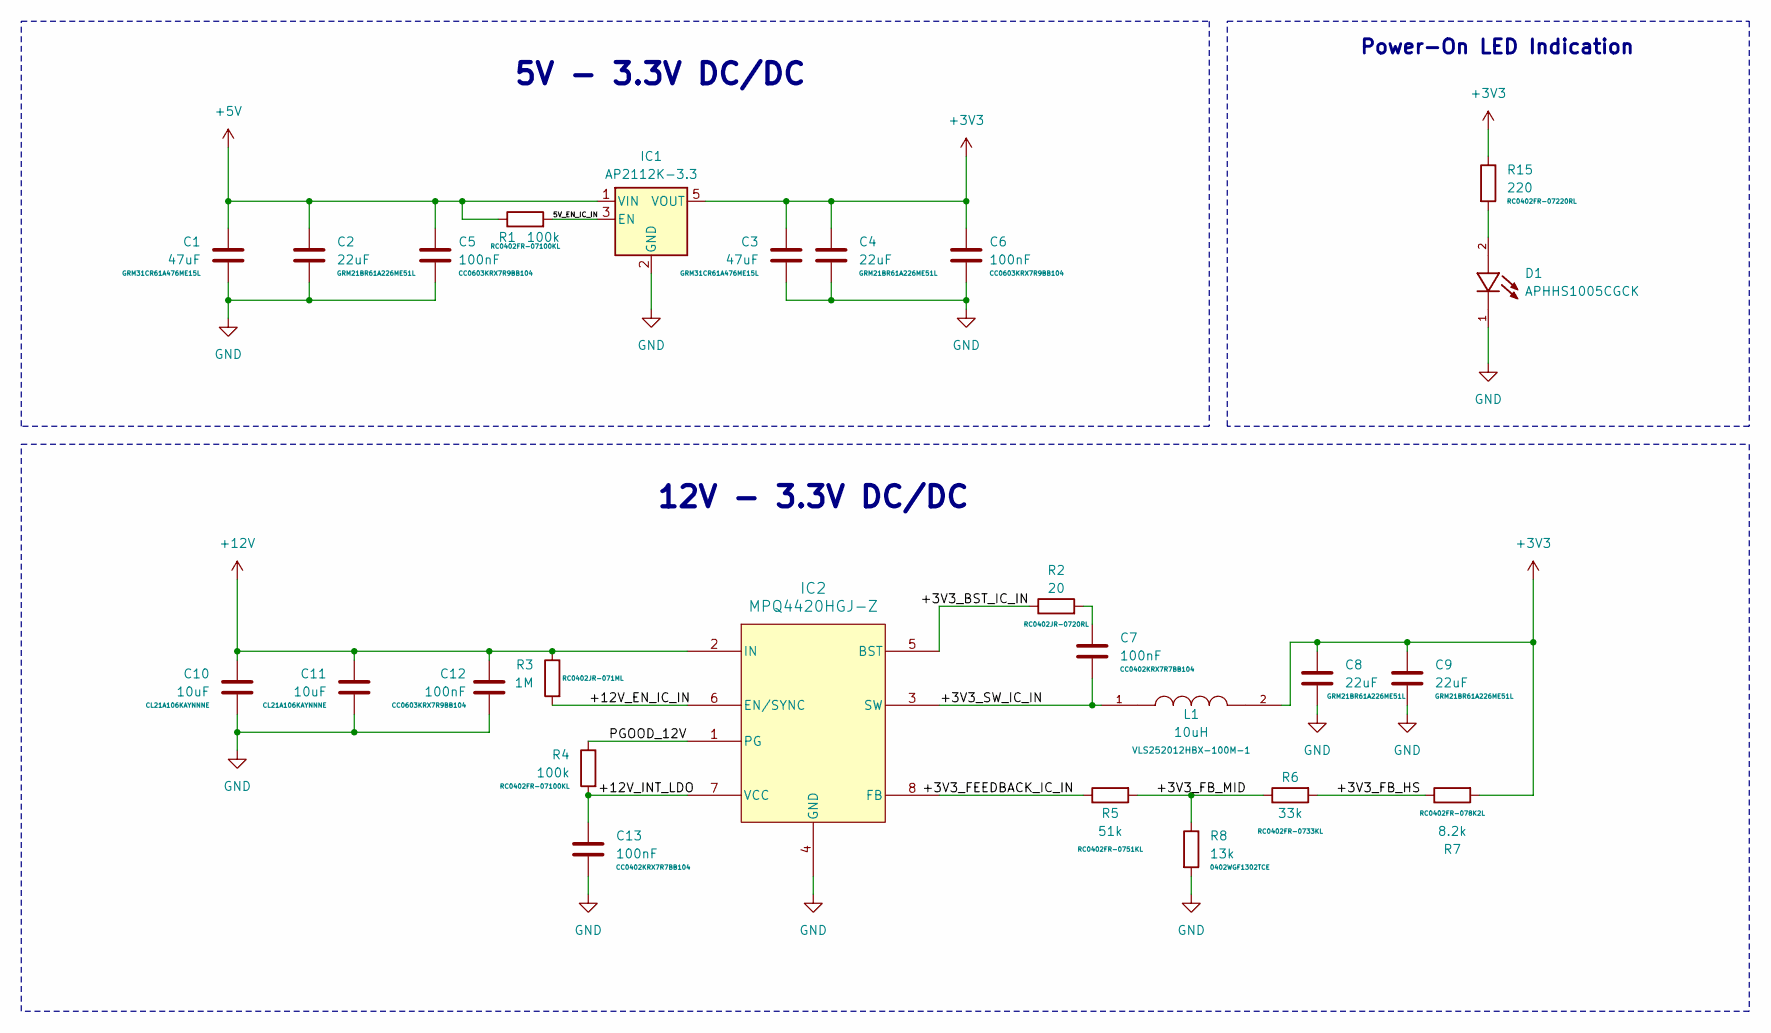
[picture p33: schematic powerManagement.kicad_sch]

Parts:
C1, C3: 47uF; CAPC3216X180N
C2, C4, C8, C9: 22uF; CAPC2012X140N
C5, C6, C12: 100nF; CC0603KRX7R9BB104
C7, C13: 100nF; CAPC1005X55N
C10, C11: 10uF; CAPC2012X135N
D1: APHHS1005CGCK; LED_APHHS1005CGCK; PARTREV V.9B
IC1: AP2112K-3.3; SOT-23-5
IC2: MPQ4420HGJ-Z; TSOT23-8_MPQ4420H_MNP
L1: 10uH; IND_VLS252012HBX-100M-1; PARTREV N/A
R1, R4: 100k; RC0402FR-07100KL
R2: 20; RESC1005X40N
R3: 1M; R0402
R5: 51k; RESC1005X40N
R6: 33k; RESC1005X40N
R7: 8.2k; RESC1005X40N
R8: 13k; RESC1005X40N
R15: 220; RESC1005X40N

Connections:
+3V3: C3.1, C4.1, C6.1, C8.1, C9.1, IC1.5 (VOUT), L1.2, R7.2, R15.1; also elsewhere on the board
+5V: C1.1, C2.1, C5.1, IC1.1 (VIN), R1.1; also elsewhere on the board
+12V: C10.1, C11.1, C12.1, IC2.2 (IN), R3.1; also elsewhere on the board
/Power Management/5V_EN_IC_IN: IC1.3 (EN), R1.2
/Power Management/+3V3_BST_IC_IN: IC2.5 (BST), R2.1
/Power Management/+3V3_FB_HS: R6.2, R7.1
/Power Management/+3V3_FB_MID: R5.2, R6.1, R8.1
/Power Management/+3V3_FEEDBACK_IC_IN: IC2.8 (FB), R5.1
/Power Management/+3V3_SW_IC_IN: C7.2, IC2.3 (SW), L1.1
/Power Management/+12V_EN_IC_IN: IC2.6 (EN/SYNC), R3.2
/Power Management/+12V_INT_LDO: C13.1, IC2.7 (VCC), R4.2
/Power Management/PGOOD_12V: IC2.1 (PG), R4.1
GND: C1.2, C2.2, C3.2, C4.2, C5.2, C6.2, C8.2, C9.2, C10.2, C11.2, C12.2, C13.2, D1.1, IC1.2 (GND), IC2.4 (GND), R8.2; also elsewhere on the board
unnamed: C7.1, R2.2
unnamed: D1.2, R15.2

Notes on the sheet:
5V - 3.3V DC/DC
12V - 3.3V DC/DC
Power-On LED Indication

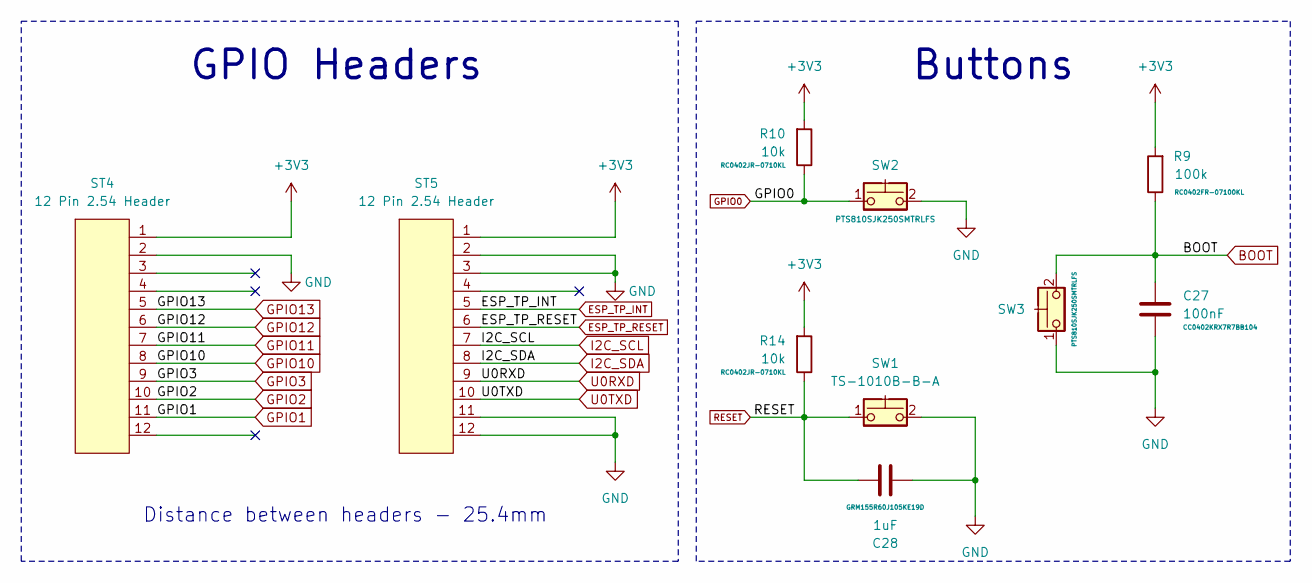
[picture p34: schematic GPIOheaders.kicad_sch]

Parts:
C27: 100nF; CAPC1005X55N
C28: 1uF; CAPC1005X55N
R9: 100k; RC0402FR-07100KL
R10, R14: 10k; RC0402JR-0710KL
ST4, ST5: 12 Pin 2.54 Header; X6511WV-12H-C60D30
SW1: TS-1010B-B-A; SW_010B-B-A_XKB
SW2, SW3: PTS810SJK250SMTRLFS; PTS810SJG250SMTRLFS

Connections:
+3V3: R9.2, R10.2, R14.2, ST4.1, ST5.1; also elsewhere on the board
BOOT: C27.1, R9.1, SW3.2; also elsewhere on the board
ESP_TP_INT: ST5.5; also elsewhere on the board
ESP_TP_RESET: ST5.6; also elsewhere on the board
GND: C27.2, C28.2, ST4.2, ST5.2, ST5.3, ST5.11, ST5.12, SW1.2, SW2.2, SW3.1; also elsewhere on the board
GPIO0: R10.1, SW2.1; also elsewhere on the board
GPIO1: ST4.11; also elsewhere on the board
GPIO2: ST4.10; also elsewhere on the board
GPIO3: ST4.9; also elsewhere on the board
GPIO10: ST4.8; also elsewhere on the board
GPIO11: ST4.7; also elsewhere on the board
GPIO12: ST4.6; also elsewhere on the board
GPIO13: ST4.5; also elsewhere on the board
I2C_SCL: ST5.7; also elsewhere on the board
I2C_SDA: ST5.8; also elsewhere on the board
RESET: C28.1, R14.1, SW1.1; also elsewhere on the board
U0RXD: ST5.9; also elsewhere on the board
U0TXD: ST5.10; also elsewhere on the board

Notes on the sheet:
Distance between headers - 25.4mm
Buttons
GPIO Headers

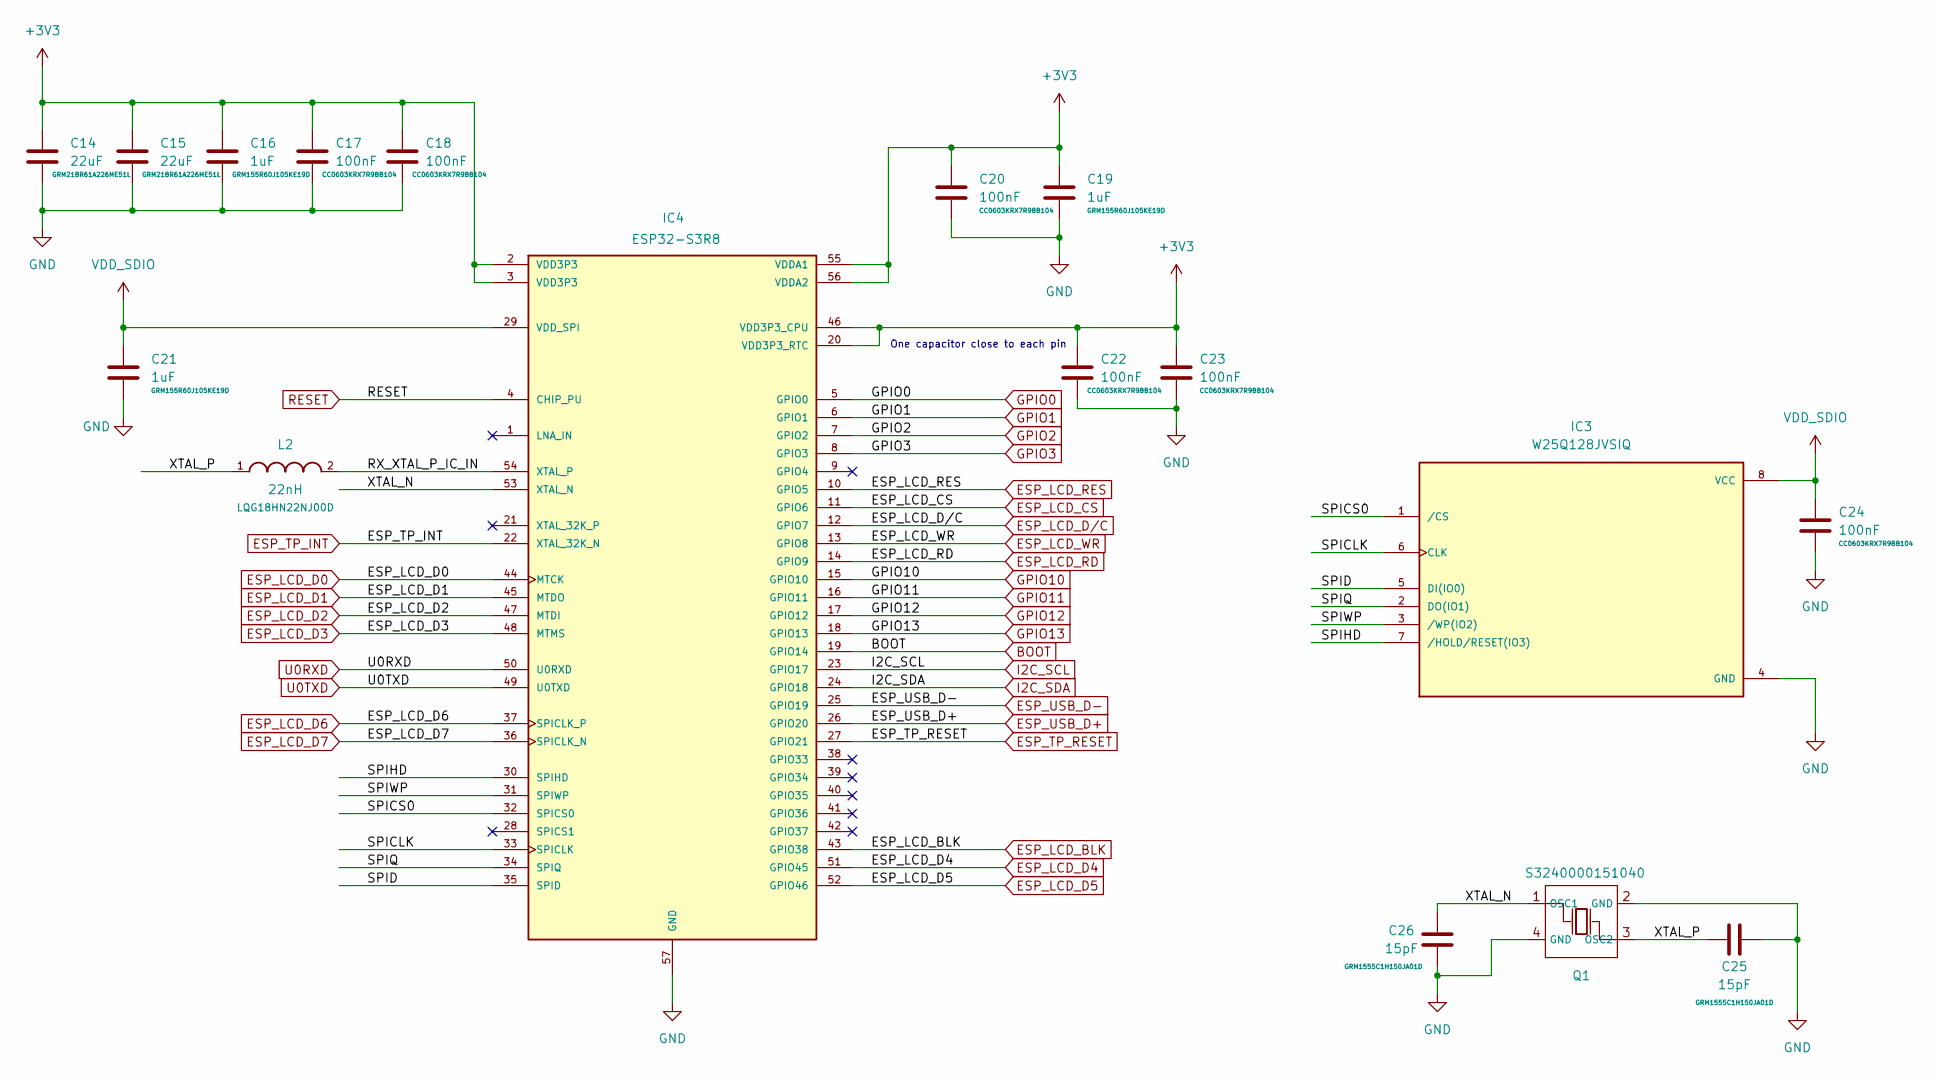
[picture p35: schematic Microcontroller.kicad_sch]

Parts:
C14, C15: 22uF; CAPC2012X140N
C16, C19, C21: 1uF; CAPC1005X55N
C17, C18, C20, C22, C23, C24: 100nF; CC0603KRX7R9BB104
C25, C26: 15pF; CAPC1005X55N
IC3: W25Q128JVSIQ; SOIC127P790X216-8N; PARTREV I
IC4: ESP32-S3R8; QFN40P700X700X90-57N
L2: 22nH; INDC1608X95N
Q1: 40MHz; CRYSTAL-SMD_4P-L3.2-W2.5-BL; Manufacturer Part S3240000151040; LCSC Part Name 40MHz ±10ppm 15pF

Connections:
+3V3: C14.1, C15.1, C16.1, C17.1, C18.1, C19.1, C20.1, C22.1, C23.1, IC4.2 (VDD3P3), IC4.3 (VDD3P3), IC4.20 (VDD3P3_RTC), IC4.46 (VDD3P3_CPU), IC4.55 (VDDA1), IC4.56 (VDDA2); also elsewhere on the board
/Microcontroller/RX_XTAL_P_IC_IN: IC4.54 (XTAL_P), L2.2
/Microcontroller/SPICLK: IC3.6 (CLK), IC4.33 (SPICLK)
/Microcontroller/SPICS0: IC3.1 (/CS), IC4.32 (SPICS0)
/Microcontroller/SPID: IC3.5 (DI(IO0)), IC4.35 (SPID)
/Microcontroller/SPIHD: IC3.7 (/HOLD/RESET(IO3)), IC4.30 (SPIHD)
/Microcontroller/SPIQ: IC3.2 (DO(IO1)), IC4.34 (SPIQ)
/Microcontroller/SPIWP: IC3.3 (/WP(IO2)), IC4.31 (SPIWP)
/Microcontroller/XTAL_N: C26.1, IC4.53 (XTAL_N), Q1.1 (OSC1)
/Microcontroller/XTAL_P: C25.1, L2.1, Q1.3 (OSC2)
BOOT: IC4.19 (GPIO14); also elsewhere on the board
ESP_LCD_BLK: IC4.43 (GPIO38); also elsewhere on the board
ESP_LCD_CS: IC4.11 (GPIO6); also elsewhere on the board
ESP_LCD_D0: IC4.44 (MTCK); also elsewhere on the board
ESP_LCD_D1: IC4.45 (MTDO); also elsewhere on the board
ESP_LCD_D2: IC4.47 (MTDI); also elsewhere on the board
ESP_LCD_D3: IC4.48 (MTMS); also elsewhere on the board
ESP_LCD_D4: IC4.51 (GPIO45); also elsewhere on the board
ESP_LCD_D5: IC4.52 (GPIO46); also elsewhere on the board
ESP_LCD_D6: IC4.37 (SPICLK_P); also elsewhere on the board
ESP_LCD_D7: IC4.36 (SPICLK_N); also elsewhere on the board
ESP_LCD_D/C: IC4.12 (GPIO7); also elsewhere on the board
ESP_LCD_RD: IC4.14 (GPIO9); also elsewhere on the board
ESP_LCD_RES: IC4.10 (GPIO5); also elsewhere on the board
ESP_LCD_WR: IC4.13 (GPIO8); also elsewhere on the board
ESP_TP_INT: IC4.22 (XTAL_32K_N); also elsewhere on the board
ESP_TP_RESET: IC4.27 (GPIO21); also elsewhere on the board
ESP_USB_D+: IC4.26 (GPIO20); also elsewhere on the board
ESP_USB_D-: IC4.25 (GPIO19); also elsewhere on the board
GND: C14.2, C15.2, C16.2, C17.2, C18.2, C19.2, C20.2, C21.2, C22.2, C23.2, C24.2, C25.2, C26.2, IC3.4 (GND), IC4.57 (GND), Q1.2 (GND), Q1.4 (GND); also elsewhere on the board
GPIO0: IC4.5 (GPIO0); also elsewhere on the board
GPIO1: IC4.6 (GPIO1); also elsewhere on the board
GPIO2: IC4.7 (GPIO2); also elsewhere on the board
GPIO3: IC4.8 (GPIO3); also elsewhere on the board
GPIO10: IC4.15 (GPIO10); also elsewhere on the board
GPIO11: IC4.16 (GPIO11); also elsewhere on the board
GPIO12: IC4.17 (GPIO12); also elsewhere on the board
GPIO13: IC4.18 (GPIO13); also elsewhere on the board
I2C_SCL: IC4.23 (GPIO17); also elsewhere on the board
I2C_SDA: IC4.24 (GPIO18); also elsewhere on the board
RESET: IC4.4 (CHIP_PU); also elsewhere on the board
U0RXD: IC4.50 (U0RXD); also elsewhere on the board
U0TXD: IC4.49 (U0TXD); also elsewhere on the board
VDD_SDIO: C21.1, C24.1, IC3.8 (VCC), IC4.29 (VDD_SPI)

Notes on the sheet:
One capacitor close to each pin

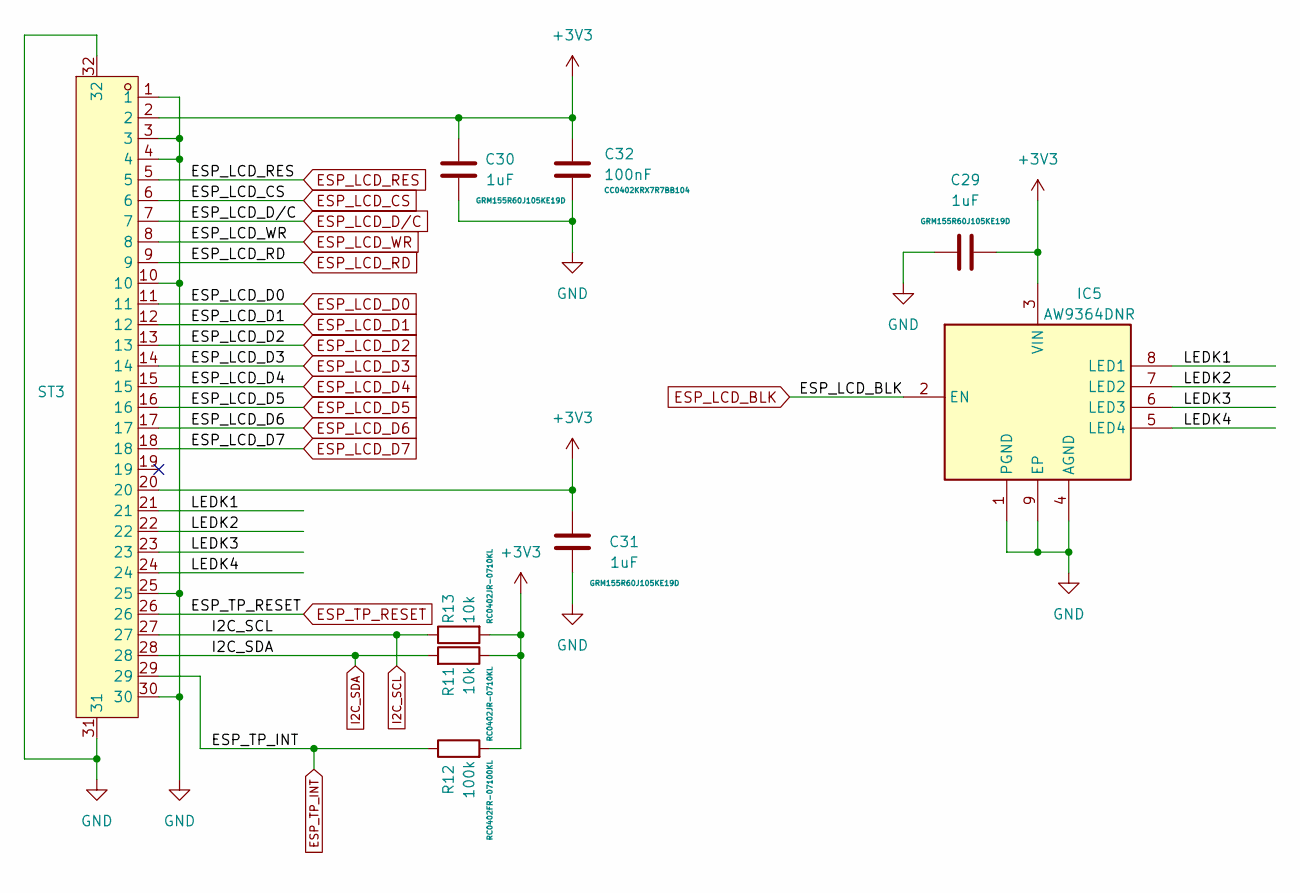
[picture p36: schematic display_conn_driver.kicad_sch]

Parts:
C29, C30, C31: 1uF; CAPC1005X55N
C32: 100nF; CAPC1005X55N
IC5: AW9364DNR; SON50P200X200X80-9N-D; Manufacturer_Part_Number AW9364DNR
R11, R13: 10k; RC0402JR-0710KL
R12: 100k; RC0402FR-07100KL
ST3: KH-CL0.5-H2.0-30PIN; Manufacturer Part KH-CL0.5-H2.0-30PIN

Connections:
+3V3: C29.1, C30.1, C31.1, C32.1, IC5.3 (VIN), R11.1, R12.2, R13.2, ST3.2, ST3.20; also elsewhere on the board
/Display Connector and Driver/LEDK1: IC5.8 (LED1), ST3.21
/Display Connector and Driver/LEDK2: IC5.7 (LED2), ST3.22
/Display Connector and Driver/LEDK3: IC5.6 (LED3), ST3.23
/Display Connector and Driver/LEDK4: IC5.5 (LED4), ST3.24
ESP_LCD_BLK: IC5.2 (EN); also elsewhere on the board
ESP_LCD_CS: ST3.6; also elsewhere on the board
ESP_LCD_D0: ST3.11; also elsewhere on the board
ESP_LCD_D1: ST3.12; also elsewhere on the board
ESP_LCD_D2: ST3.13; also elsewhere on the board
ESP_LCD_D3: ST3.14; also elsewhere on the board
ESP_LCD_D4: ST3.15; also elsewhere on the board
ESP_LCD_D5: ST3.16; also elsewhere on the board
ESP_LCD_D6: ST3.17; also elsewhere on the board
ESP_LCD_D7: ST3.18; also elsewhere on the board
ESP_LCD_D/C: ST3.7; also elsewhere on the board
ESP_LCD_RD: ST3.9; also elsewhere on the board
ESP_LCD_RES: ST3.5; also elsewhere on the board
ESP_LCD_WR: ST3.8; also elsewhere on the board
ESP_TP_INT: R12.1, ST3.29; also elsewhere on the board
ESP_TP_RESET: ST3.26; also elsewhere on the board
GND: C29.2, C30.2, C31.2, C32.2, IC5.1 (PGND), IC5.4 (AGND), IC5.9 (EP), ST3.1, ST3.3, ST3.4, ST3.10, ST3.25, ST3.30, ST3.31, ST3.32; also elsewhere on the board
I2C_SCL: R13.1, ST3.27; also elsewhere on the board
I2C_SDA: R11.2, ST3.28; also elsewhere on the board

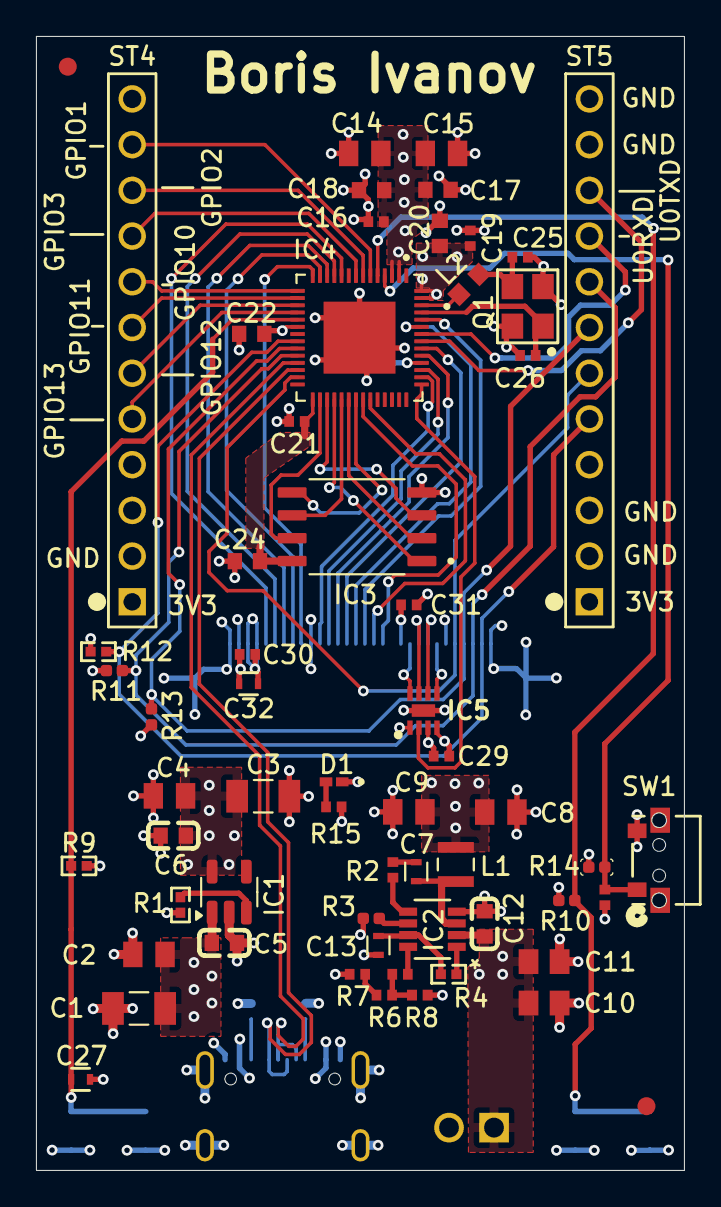
[picture p37: board ESP32_BOARD.kicad_pcb from above]

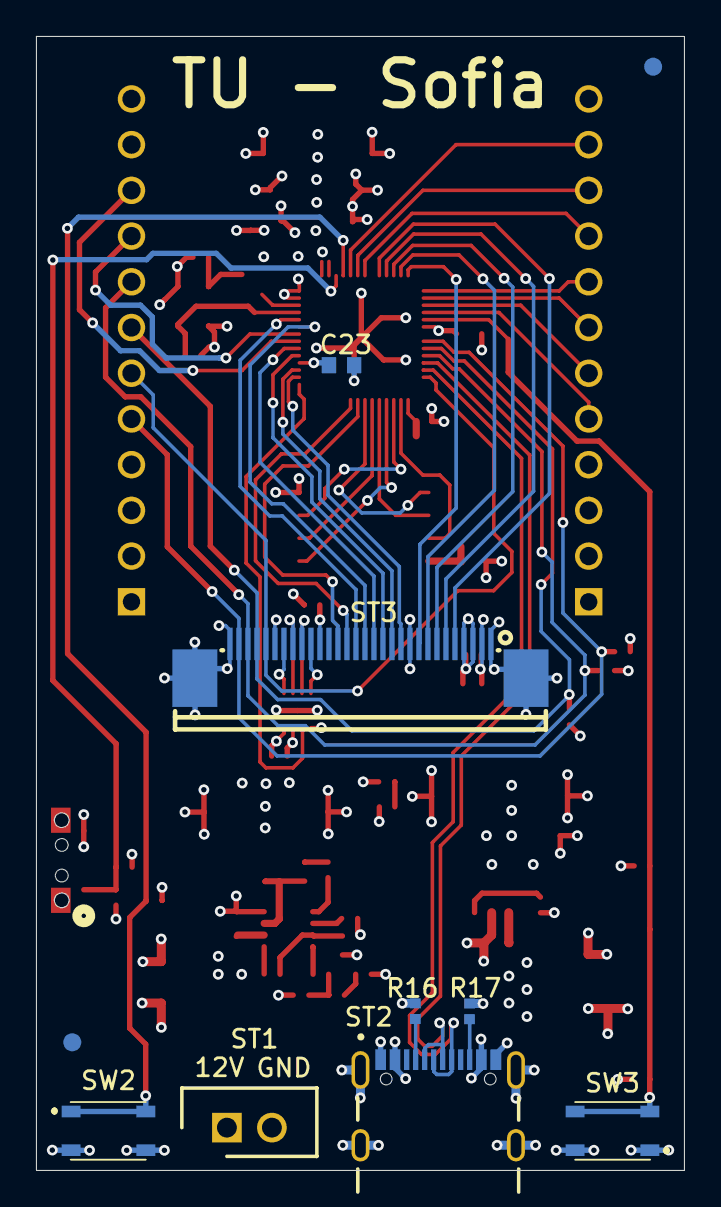
[picture p38: board ESP32_BOARD.kicad_pcb from below]

Board: 4 copper layers, 36.0 x 63.0 mm, 70 parts (10 on the bottom side), 63 nets.
