BorisIvanovGIT/DiplomnaRabota/(commit log)

2025-04-12 Commit test
    [GPIOheaders.kicad_sch]
2025-04-12 test 3
    [Microcontroller.kicad_sch]
2025-04-12 test 4
    [Microcontroller.kicad_sch]
2025-04-13 Crystal Change
    Crystal changed from active (CMSO) to passive with 2x 15pF load capacitors
    [ESP32_BOARD.kicad_pcb, Microcontroller.kicad_sch]
2025-04-13 Some small fixes
    Swapped the pins on the oscillator
    [Microcontroller.kicad_sch]
2025-04-14 Changes to final schematic
    [APHHS1005CGCK.step, ESP32_BOARD.kicad_pcb, GPIOheaders.kicad_sch, Microcontroller.kicad_sch, RC0402FR-07220RL.step, inputConnectors.kicad_sch, powerManagement.kicad_sch]
2025-04-15 Layout Started
    Board setup done, DC/DC Converters arranged and slight changes tot he board outline.
    [ESP32_BOARD.kicad_pcb]
2025-04-15 Arranged Headers + Added pull-down resistors for type-c conn
    [0402WGF5101TCE.step, ESP32_BOARD.kicad_pcb, inputConnectors.kicad_sch]
2025-04-16 JST 2 PIN CONN Changed + Additional 3D Models added
    [AW9364DNR.stp, B2B-EH-A_LF__SN_.stp, ESP32_BOARD.kicad_pcb, S3240000121040.stp, inputConnectors.kicad_sch, ts-1010b-b-a.stp]
2025-04-17 Origin of PCB Layout changed
    [ESP32_BOARD.kicad_pcb]
2025-04-21 Lazy Layout Done
    Needed additional movement of the components to achieve better routing
    [ESP32_BOARD.kicad_pcb]
2025-04-22 Most of the layout done
    [ESP32_BOARD.kicad_pcb, GPIOheaders.kicad_sch]
2025-04-23 Routing done | First Iteration
    Silkscreen of components kinda done
    [ESP32_BOARD.kicad_pcb]
2025-04-23 Minor adjustments to the layout and the silkscreen
    [ESP32_BOARD.kicad_pcb]
2025-04-24 Layout ready for export
    [ESP32_BOARD.kicad_pcb]
2025-04-24 Finished Layout | Ver. 1.0
    Layout finished for ver. 1.0
    Design at a stage before the review from the colleagues
    [ESP32_BOARD.kicad_pcb]
2025-04-24 Gerbers and BOM Generated
    Gerbers and BOM are generated and added to the project folder
    [ESP32_BOARD-Bot_Cu.gbr, ESP32_BOARD-Bot_Mask.gbr, ESP32_BOARD-Bot_Paste.gbr, ESP32_BOARD-Bot_Silkscreen.gbr, ESP32_BOARD-Edge_Cuts.gbr, ESP32_BOARD-In1_Cu.gbr, ESP32_BOARD-In2_Cu.gbr, ESP32_BOARD-NPTH-drl.gbr]
2025-04-24 Problems with manufacturing files
    [ESP32_BOARD.kicad_pcb, ESP32_BOARD_BOM.csv, ESP32_BOARD_BOM_unformated.csv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]
2025-04-24 BOM Files Fixed
    [ESP32_BOARD_BOM.csv, ESP32_BOARD_BOM.xlsx, ESP32_BOARD_BOM_unformated.csv, TYPE-C_16PIN_2MD__073_.step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]
2025-04-24 Gerb Files Fixed | Drill File Updated
    [ESP32_BOARD-Bot_Cu.gbr, ESP32_BOARD-Bot_Mask.gbr, ESP32_BOARD-Bot_Paste.gbr, ESP32_BOARD-Bot_Silkscreen.gbr, ESP32_BOARD-Edge_Cuts.gbr, ESP32_BOARD-In1_Cu.gbr, ESP32_BOARD-In2_Cu.gbr, ESP32_BOARD-NPTH-drl.gbr]
2025-04-28 PCB Review Documents Generated
    [ESP32_BOARD.kicad_pcb]
2025-05-29 Minor changes to styling
    [Microcontroller.kicad_sch, display_conn_driver.kicad_sch]
2025-06-24 Промяна по оформление и текст в схемата
    [ESP32_BOARD_BOM.xlsx, display_conn_driver.kicad_sch, inputConnectors.kicad_sch]
